fabiomatos999/ICOM-4217-Project/Final Project Report/Introduction/introduction.tex

\section{Introduction}
In 2017 hurricane Maria devastated the northeastern Caribbean, particularly Dominica, Saint Croix, and Puerto Rico. In the wake of the storm, Puerto Rico suffered the longest blackout in US history and the second longest blackout in recorded human history\cite{WorldSecondLargest}. The revised death count attributable to the hurricane was 2,975 people\cite{HurricaneMariaCaused2018}. According to an investigation by the New York Times, deaths caused by  sepsis, pneumonia, emphysema, diabetes, and Alzheimer's and Parkinson's spiked in the two months following the hurricane\cite{roblesOfficialTollPuerto2017}. The whole island of Puerto Rico was declared a disaster zone by the Federal Emergency Management Agency (FEMA) and it wasn't until four to eight months after the storm that most of the population had electricity and running water after the storm. The Puerto Rican electrical grid also collapsed in the aftermath of hurricane Fiona in September of 2022. Puerto Rico also has a sizable portion of the adult population with diabetes and a large portion of those diagnosed with diabetes require insulin to survive\cite{DiabetesPrevalencePopulation}. The rationale for this project is to provide a tool for users of insulin to be sure that their medication is safe and effective in normal and post disaster conditions. The problem is that there has not been a way to monitor the storage conditions of insulin in a consumer setting in normal/post-disaster conditions. This project's solution to this problem is to create a micro-controller based design that can:
\begin{itemize}
  \item Monitor the temperature of the insulin.
  \item Check if a power outage has occurred.
  \item Warn the main unit if the temperature has exceeded has deviated from the recommended guidelines, 2\si{\celsius} to 8\si{\celsius}, and turn on a warning light on the sub unit.
  \item Record the temperature, timestamp and power availability on a log file on the main unit.
  \item Let the main unit warn an operator if a sub-unit has exceeded temperature guidelines.
  \item The main unit send its logging information to a server.
\end{itemize}
