fabiomatos999/ICOM-4217-Project/Final Project Report/Title-Page/title-page.tex

\begin{titlepage}
  \begin{center}
    \large{University of Puerto Rico\\
    Mayagüez Campus\\
    \vspace{\baselineskip}
    Department of Electrical and Computer Engineering\\}
    \vspace{6cm}
    \Huge{\underline{Insulin Temperature Warning System}\\}
    \vspace{0.3\baselineskip}
    \large{Final Report\\}
    \vspace{0.8\baselineskip}
    \large by\\
    Fabio J. Matos Nieves\\
    Enrique Chompré González\\
    \vspace{5.5cm}
    For: Professor Manuel Jimenez\\
    Course: ICOM 4217 Seccion 096\\
    Date: May 8, 2023\\
    \normalsize

  \end{center}
\end{titlepage}
