fabiomatos999/ICOM-4217-Project/PROTOTYPE INTEGRATION and System Updates/System-Schematic-Diagrams/system-schematic-diagrams.tex

\section{System Schematic Diagrams}
\begin{landscape}
  \begin{center}
  \begin{figure}[H]
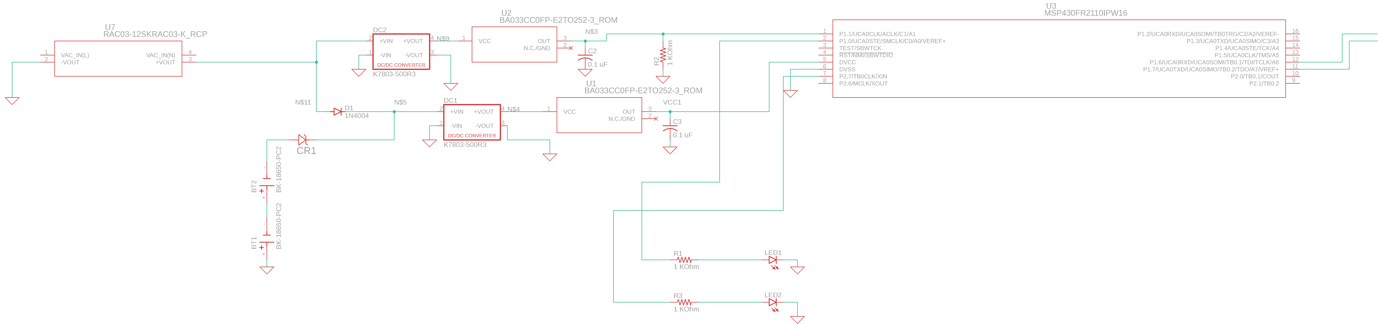
[picture p9: PROTOTYPE INTEGRATION and System Updates/System-Schematic-Diagrams/Figures/main-unit-and-psu.png]
    
    \caption{Main Unit with PSU Schematic}
    \label{fig:main-with-psu-schematic}
  \end{figure}
  \end{center}
  \begin{center}
  \begin{figure}[H]
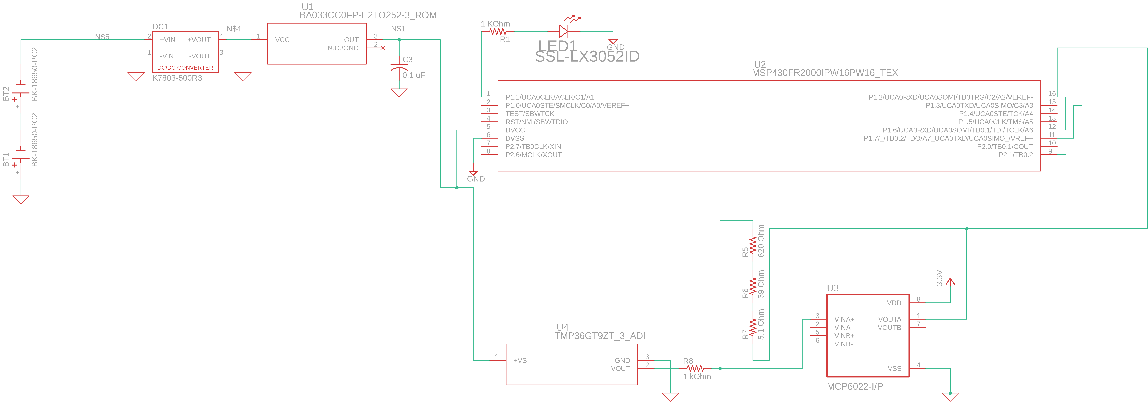
[picture p10: PROTOTYPE INTEGRATION and System Updates/System-Schematic-Diagrams/Figures/sub-unit-and-psu.png]
    
    \caption{Sub Unit with PSU Schematic}
    \label{fig:sub-with-psu-schematic}
  \end{figure}
  \end{center}
\end{landscape}
