fabiomatos999/ICOM-4217-Project/Hardware Design and System Updates/Main-Document/main-document.tex

\documentclass[12pt]{article}
\usepackage{amsmath}
\usepackage[export]{adjustbox}
\usepackage{unicode}
\usepackage[table]{xcolor}
\usepackage{longtable}
\usepackage{pdflscape}
\usepackage{siunitx}
\usepackage{svg}
\usepackage{setspace}
\usepackage[scaled]{helvet}
\renewcommand\familydefault{\sfdefault} 
\usepackage[T1]{fontenc}
\usepackage[numbers]{natbib} 
\usepackage{tabularx}
\usepackage[hidelinks]{hyperref} 
\hypersetup{ colorlinks, citecolor=black,
  filecolor=black, 
  linkcolor=black,
  urlcolor=blue,
  pdftitle={Hardware Design and System Updates},
  pdfpagemode=FullScreen,
}
\usepackage{float}
\usepackage{graphicx} 
\usepackage{pdfpages} 
\usepackage{tabularx}
\usepackage{tikz}
\newcommand\createfigurew[3]{
  \begin{center}
  \begin{figure}[H]
    \centering 
    \caption{#2}
    \label{#3}
  \end{figure}
  \end{center}
}
\newcommand\createfigurel[3]{
  \begin{center}
  \begin{figure}[H]
    \centering 
    \caption{#2}
    \label{#3}
  \end{figure}
  \end{center}
}
\newcommand\createfigurewsvg[3]{
 \begin{figure}[H]
  \begin{center}
    \centering\includesvg[width=\textwidth]{#1}
    \caption{#2}
    \label{#3}
  \end{center}
 \end{figure}
}
\usepackage{etoolbox}
\apptocmd{\thebibliography}{\raggedright}{}{}
\begin{document}
\linespread{1.0}
\input{../Title-Page/title-page.tex}
\linespread{2.0}
\tableofcontents
\listoffigures
\listoftables
\input{../Task-Delegation/task-delegation.tex}
\input{../BDv3/bdv3.tex}
\input{../System-Schematic-Diagrams/system-schematic-diagrams.tex}
\input{../BOM/bom.tex}
\input{../Power-Voltage-Compatability-and-Timing-Analyses/power-voltage-compatability-and-timing-analysis.tex}
\input{../Cost Analysis/cost-analysis.tex}
\input{../Detailed-Software-Plan/detailed-software-plan.tex}
\input{../Updated-Project-Poster/updated-project-poster.tex}
\input{../References/references.tex}
\end{document}
