fabiomatos999/ICOM-4217-Project/Hardware Design and System Updates/System-Schematic-Diagrams/system-schematic-diagrams.tex

\section{System Schematic Diagrams}
\begin{landscape}
  \begin{center}
  \begin{figure}[H]
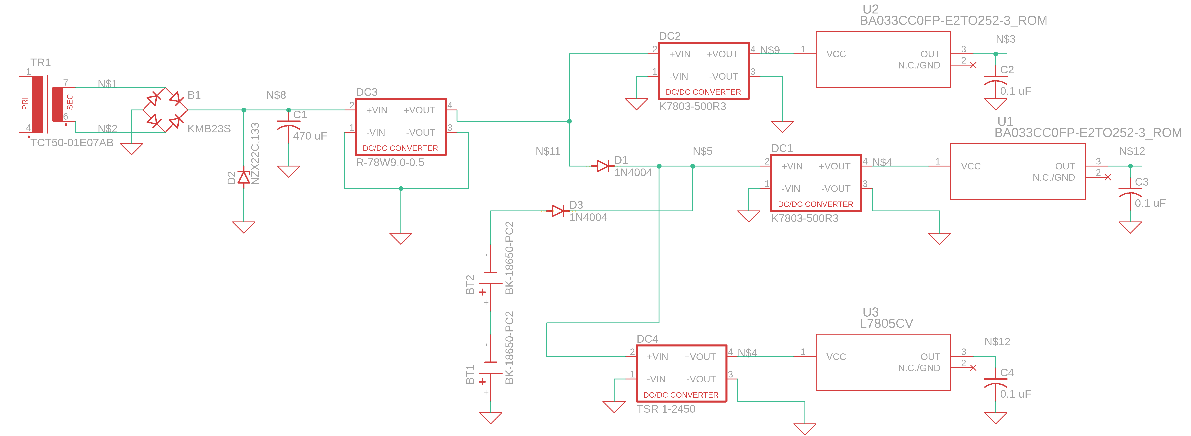
[picture p11: Hardware Design and System Updates/Power-Supply/Main Unit PSU/main-unit-psu.png]
    
    \caption{Main Unit PSU Schematic}
    \label{fig:main-psu-schematic}
  \end{figure}
  \end{center}
\createfigurew{../Power-Supply/Sub Unit PSU/sub-unit-psu.png}{Sub Unit PSU Schematic}{fig:sub-psu-schematic}
  \begin{center}
  \begin{figure}[H]
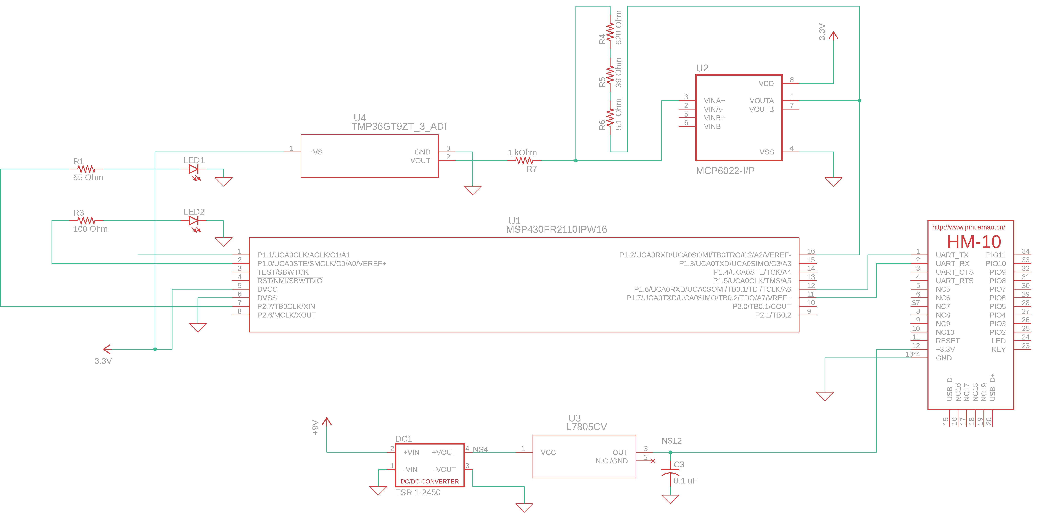
[picture p12: Hardware Design and System Updates/Main-Unit/Figures/Main-Unit.png]
    
    \caption{Main Unit Schematic}
    \label{fig:main-unit-schematic}
  \end{figure}
  \end{center}
  \begin{center}
  \begin{figure}[H]
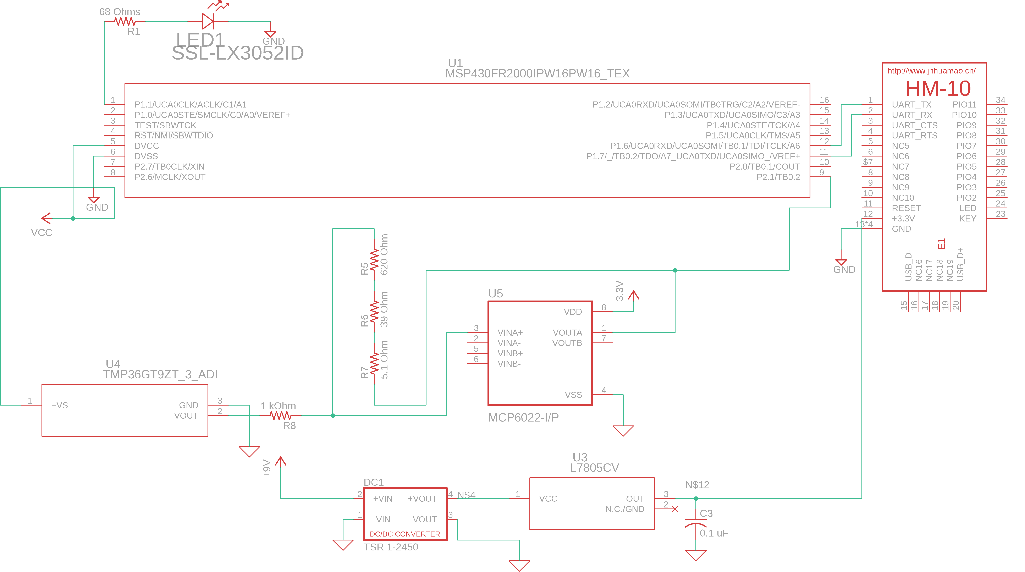
[picture p13: Hardware Design and System Updates/Sub-Unit/Figures/sub-unit.png]
    
    \caption{Sub Unit Schematic}
    \label{fig:sub-unit-schematic}
  \end{figure}
  \end{center}
  \begin{center}
  \begin{figure}[H]
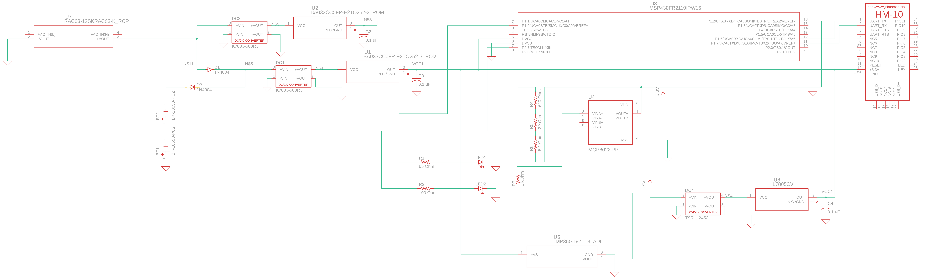
[picture p14: Hardware Design and System Updates/Main-Unit-and-PSU/Figures/main-unit-and-psu.png]
    
    \caption{Main Unit with PSU Schematic}
    \label{fig:main-with-psu-schematic}
  \end{figure}
  \end{center}
  \begin{center}
  \begin{figure}[H]
    
    \caption{Sub Unit with PSU Schematic}
    \label{fig:sub-with-psu-schematic}
  \end{figure}
  \end{center}
\end{landscape}
