fabiomatos999/ICOM-4217-Project/Hardware Design and System Updates/Task-Delegation/task-delegation.tex

\section{Delegation of Tasks}
For this proposal, the Insulin Temperature Warning System was modulerized into 3 separate parts, those being:
\begin{itemize}
  \item Main Unit
  \item Sub Unit
  \item PSU
\end{itemize}
The main unit consists of the MSP430FR2110 and the HM-10 BLE Bluetooth module. The sub unit consists of MSP430FR2000, a HM-10 BLE Bluetooth module and a red LED. The PSU consists of 2 individual parts:
\begin{itemize}
  \item Main Unit PSU
  \item Sub unit PSU
\end{itemize}
The main unit consists of a 3.3\si{\V} power supply along with a 3.3\si{\V} voltage sense for a GPIO pin with a battery backup circuit.  The sub unit PSU consists of a 3.3\si{\V} regulated battery supply.\\
The following table demonstrates how the modules were distributed within the team:
\begin{table}[h]
\begin{center}
\begin{tabularx}{\textwidth}{|X|X|}
 \hline
 Team Member & Assigned Module\\
 \hline
 Fabio J. Matos Nieves & PSU\\
 \hline
 Enrique Chompré González& Main Unit\\
 \hline
 Guillermo Colón Bernardi& Sub Unit\\
 \hline
\end{tabularx}
\end{center}
\caption{Team Member Roles}
\label{Task-Delegation}
\end{table}
