fabiomatos999/ICOM-4217-Project/Hardware Design and System Updates/Title-Page/title-page.tex

\begin{titlepage}
  \begin{center}
    \large{University of Puerto Rico\\
    Mayagüez Campus\\
    \vspace{\baselineskip}
    Department of Electrical and Computer Engineering\\}
    \vspace{6cm}
    \Huge{\underline{Insulin Temperature Warning System}\\}
    \vspace{0.5\baselineskip}
    \large by\\
    Fabio J. Matos Nieves\\
    Enrique Chompré González\\
    Guillermo Colón Bernardi\\
    \vspace{4.5cm}
    For: Professor Manuel Jimenez\\
    Course: ICOM 4217 Seccion 096\\
    Date: March 13, 2023\\
    \normalsize

  \end{center}
\end{titlepage}
