fabiomatos999/ICOM-4217-Project/Proposal/Design-Criteria/design-criteria.tex

\section{Design Criteria}
\begin{enumerate}
  \item Power/Energy: The sub-units are supposed to last at least 2 years only using a battery and the main unit is supposed to operate on a UPS for an extended period of time in case of a blackout, thus being cognizant of a power budget is critical for this design.
  \item Economic: This design is supposed to be inexpensive enough so that the sub-units can be embedded in a box of insulin at a factory or pharmacy.
  \item Manufacturability: This design used off the shelf parts that are being actively manufactured and are easy to assemble and can easily fit in a box of insulin.
\end{enumerate}
