fabiomatos999/ICOM-4217-Project/Proposal/Abstract/abstract.tex

\section*{Abstract}
The purpose of this document is outlining a design for a pair of devices that monitor the temperature of insulin, making sure that it meets the safe storage guidelines in a mass storage context. This document contains the system conception, system architecture \& functionality, specifications and market description as well as the project time table, design criteria and the opinion of the client of this design.
