fabiomatos999/ICOM-4217-Project/PROTOTYPE INTEGRATION and System Updates/System-Schematic-Diagrams/Main-Unit/Main-Unit-Schematic.txt

Partlist exported from C:/Users/enriq/Documents/EAGLE/projects/ICOM4217/Main-Unit-Schematic.sch at 3/12/2023 8:02 PM

Qty Value             Device            Package           Parts Description                                                                                                                                                                                                                                                          AVAILABILITY COPYRIGHT                                                DESCRIPTION                                                                     MANUFACTURER_PART_NUMBER MF                      MFR_NAME          MP    PACKAGE  PRICE
1   HM-10-BOARD       HM-10-BOARD       26.9X13X2.2_BOARD E1    HM Bluetooth module use TI CC2540 or CC2541, Master and slave roles in one, transmission version and remote control version and PIO state acquisition functions in one, Support the AT command modify module parameters, Convenient and flexible. Check availability Not in stock                                                           Bluetooth 4.0 module with 4pin base board that can support iphone4s or later.                           Jinan Huamao Technology                   HM-10 Package  None 
1   MSP430FR2110IPW16 MSP430FR2110IPW16 PW16_TEX          U1                                                                                                                                                                                                                                                                                      Copyright (C) 2023 Ultra Librarian. All rights reserved.                                                                                 MSP430FR2110IPW16                                Texas Instruments
