fabiomatos999/ICOM-4217-Project/PROTOTYPE INTEGRATION and System Updates/Main-Document/main-document.tex

\documentclass[12pt]{article}
\usepackage{setspace}
\usepackage{float}
\usepackage{svg}
\usepackage{pdflscape}
\usepackage{longtable}
\usepackage{tikz}
\usepackage{amsmath}
\usepackage[scaled]{helvet}
\renewcommand\familydefault{\sfdefault}
\usepackage{caption}
\usepackage{subcaption}
\usepackage[hidelinks]{hyperref}
\usepackage[numbers]{natbib}
\usepackage{tabularx}
\usepackage[export]{adjustbox}
\hypersetup{ colorlinks, citecolor=black,
  filecolor=black,
  linkcolor=black,
  urlcolor=blue,
  pdftitle={Hardware Design and System Updates},
  pdfpagemode=FullScreen,
}
\usepackage{siunitx}
\usepackage{tabularx}
\usepackage{bookmark}
\bookmarksetup{
  numbered,
  open,
}
\usepackage{caption}
\usepackage[newfloat]{minted}
\newcommand\createfigurew[3]{
  \begin{center}
  \begin{figure}[H]
    \centering 
    \caption{#2}
    \label{#3}
  \end{figure}
  \end{center}
}
\newcommand\createfiguresw[4]{
  \begin{center}
  \begin{figure}[H]
    \centering 
    \caption{#3}
    \label{#4}
  \end{figure}
  \end{center}
}
\newcommand\createfigurel[3]{
  \begin{center}
  \begin{figure}[H]
    \centering 
    \caption{#2}
    \label{#3}
  \end{figure}
  \end{center}
}
\newcommand\createfigurewsvg[3]{
 \begin{figure}[H]
  \begin{center}
    \centering\includesvg[width=\textwidth]{#1}
    \caption{#2}
    \label{#3}
  \end{center}
 \end{figure}
}
\usepackage{etoolbox}
\apptocmd{\thebibliography}{\raggedright}{}{}
\newenvironment{code}{\captionsetup{type=listing}}{}
\SetupFloatingEnvironment{listing}{name=Source Code}
\begin{document}
\linespread{1.0}
 \input{../Title-Page/title-page.tex}
\linespread{2.0}
 \tableofcontents
 \listoffigures
 \listoftables
 \input{../Completion-Table/completion-table.tex}
 \input{../BDv5/BDv5.tex}
 \input{../System-Schematic-Diagrams/system-schematic-diagrams.tex}
 \input{../Bill-Of-Materials/bill-of-materials.tex}
 \input{../Power-Voltage-Compatability-Timing-Analysis/power-voltage-compatability-timing-analysis.tex}
 \input{../System-Integration-Table/system-integration-table.tex}
 \input{../System-Core-Design/system-core-design.tex}
 \input{../Individual-BD-SCH-Pictures/individual-bd-sch-pictures.tex}
 \input{../References/references.tex}
 \input{../Detailed-Software-Plan-Per-Module/detailed-software-plan-per-module.tex}
\end{document}
