fabiomatos999/ICOM-4217-Project/PROTOTYPE INTEGRATION and System Updates/Detailed-Software-Plan-Per-Module/detailed-software-plan-per-module.tex

\appendix
\section{Detailed Software Plan Per Module}
\subsection{Main Unit}
\createfiguresw{0.50\textwidth}{../Detailed-Software-Plan-Per-Module/Figures/main-unit-main-function.png}{Main Unit Main Function Flowchart}{fig:main-unit-main-function-flowchart}
\createfiguresw{0.54\textwidth}{../Detailed-Software-Plan-Per-Module/Figures/main-unit-rtc-isr.png}{Main Unit RTC ISR Flowchart}{fig:main-unit-rtc-isr-flowchart}
\createfigurew{../Detailed-Software-Plan-Per-Module/Figures/main-unit-bluetooth-isr.png}{Main Unit Bluetooth ISR Flowchart}{fig:main-unit-bluetooth-isr-flowchart}
\input{../Detailed-Software-Plan-Per-Module/Figures/main-unit-fsd.tex}
\newpage
\createfigurew{../Detailed-Software-Plan-Per-Module/Figures/main-unit-main-function-pseudo-code.png}{Main Unit Main Function Pseudo Code}{fig:main-unit-main-function-pseudo-code}
\createfigurew{../Detailed-Software-Plan-Per-Module/Figures/main-unit-rtc-isr-pseudo-code.png}{Main Unit RTC ISR Pseudo Code}{fig:main-unit-rtc-isr-pseudo-code}
\createfigurew{../Detailed-Software-Plan-Per-Module/Figures/main-unit-bluetooth-isr-pseudo-code.png}{Main Unit Bluetooth ISR Pseudo Code}{fig:main-unit-bluetooth-isr-pseudo-code}
\begin{code}
\captionof{listing}{Main Unit main.c}
\label{code:main-unit-main.h}
 \begin{minted}[breaklines,breakanywhere]{C}
#include <msp430.h> 
#include <temperatureSensor.h>
#include <bluetooth.h>

typedef enum
{
    OLD, FROZEN, COLD, WARM, HOT, TRASH, NONE
} ERROR;

char*ERROR_STRING[7] = {
    "OLD",
    "FROZEN",
    "COLD",
    "WARM",
    "HOT",
    "TRASH",
    "NONE"
};

char LOT[30] = "ABCDEFGHIJKLMNOPQRSTUVWXYZ1234";

void raiseError(ERROR err);

unsigned char ownerAddr[12];
unsigned char subAddr[12];
const unsigned int expDateHours = 17520;
ERROR error = NONE;

int main(void)
{
    WDTCTL = WDTPW | WDTHOLD;   // stop watchdog timer

//    PM5CTL0 &= ~LOCKLPM5;//sends GPIO pins to low impedance mode
    P4OUT &= ~(BIT1 + BIT0);
    P4DIR |= BIT1+BIT0;//P2.1 = GREEN LED, P2.0= RED LED, P2.2= Voltage sensing pin
    P1REN |= BIT3;
    P1IE |= BIT3;
    if (((P1IN>>3)& 1)==1){//verifies that power is present
                P4OUT &= ~BIT0;
                P4OUT |= BIT1;
                P1IES |= BIT3;
                //toggles LEDs
            }
            else {
                P4OUT &= ~BIT1;
                P4OUT |= BIT0;
                P1IES &= ~BIT3;

                //toggles LEDs
            }
    P1IFG &= ~BIT3;
    P1SEL0 |= BIT6 + BIT7;//UART Pins P1.6=RX, P1.7=TX
    UCA0CTLW0 |= UCSWRST;
    UCA0CTLW0 |= UCSSEL_2;
    UCA0BR0 = 6; //baud rate
    UCA0BR1 = 0x00;
    UCA0MCTLW = UCOS16 + (13<<4) + (0x22<<8);
    UCA0CTLW0 &= ~UCSWRST;
    UCA0IE |= UCRXIE;//enable interrupts for the receiver
    P3SEL = BIT4 + BIT5;
    UCA0CTL1 |= UCSWRST;
    UCA0CTL1 |= UCSSEL_2;
    UCA0BR0 = 109;
    UCA0BR1 = 0x00;
    UCA0MCTL = UCBRS_2+UCBRF_0;
    UCA0CTL1 &= ~UCSWRST;
    UCA0IE |= UCTXIE + UCRXIE;
    UCA0TXBUF = 'A';
    __enable_interrupt();
    __bis_SR_register(LPM3_bits | GIE);
    __no_operation();
}

#pragma vector=PORT1_VECTOR
__interrupt void PORT1_ISR(void)
{
    switch(__even_in_range(P1IV,16)){
    case 8:
        if (((P1IN>>3)& 1)==1){//verifies that power is present
            P4OUT &= ~BIT0;
            P4OUT |= BIT1;
            P1IES |= BIT3;

            //toggles LEDs
        }
        else {
            P4OUT &= ~BIT1;
            P4OUT |= BIT0;
            P1IES &= ~BIT3;
            //toggles LEDs
        }
    break;
    default:
    break;
    }
    __bis_SR_register_on_exit(LPM3_bits);

}

#pragma vector=USCI_A0_VECTOR
__interrupt void USCI_A0_ISR(){
    switch(__even_in_range(UCA0IV,4)){//takes first 3 bits
    case 0: break; //Irrelevant
    case 2:
        if (rxcharindex < BTBUFSIZE && rxcharindex < strlen(BTRXBUF)){
            UCA0RXBUF = BTRXBUF[rxcharindex];//receiver buffer
            rxcharindex += 1;
        }
        break;
    case 4:
        if (txcharindex < BTBUFSIZE && txcharindex < strlen(BTTXBUF)){
            UCA0TXBUF = BTTXBUF[txcharindex];//transmitter buffer
            txcharindex += 1;
        }
        break;
    default: break;
    }
}
 \end{minted}
\end{code}
\begin{code}
\captionof{listing}{Main Unit Bluetooth.h}
\label{code:main-unit-bluetooth.h}
 \begin{minted}[breaklines,breakanywhere]{C}
#include <stdio.h>
#include <string.h>

#define BTBUFSIZE 81
char BTTXBUF[BTBUFSIZE];
char BTRXBUF[BTBUFSIZE];

unsigned int txcharindex = 0;
unsigned int rxcharindex = 0;

char *AT_COMMANDS[] = {
        "AT\0",           // 0 Test Command
        "AT+ADDR?\0",     // 1 Query module address
        "AT+BAUD?\0",     // 2 Query baud rate
        "AT+BAUD[]\0",    // 3 Set baud rate
        "AT+CLEAR\0",     // 4 Clear Last Connected device address
        "AT+CONNL\0",     // 5 Try connect to last succeeded device
        "AT+CON[]\0",     // 6 Try connect an address
        "AT+FILT?\0",     // 7 Query filter AT command parameter in AT+MODE value is 2
        "AT+FILT[]\0",    // 8 Set filter AT command parameter in AT+MODE value is 2
        "AT+HELP?\0",     // 9 System Help Information
        "AT+IMME?\0",     // 10 Query Module work type
        "AT+IMME[]\0",    // 11 Set Module work type
        "AT+MODE?\0",     // 12 Query Module Work Mode
        "AT+MODE[]\0",    // 13 Set Module Work Mode
        "AT+NOTI\0",      // 14 Query Notify information
        "AT+NOTI[]\0",    // 15 Set Notify information
        "AT+NAME?\0",     // 16 Query Module name
        "AT+NAME[]\0",    // 17 Set Module name
        "AT+PARI?\0",     // 18 Query Parity bit
        "AT+PARI[]\0",    // 19 Set Parity bit
        "AT+PIO1?\0",     // 20 Query PIO1 output status (System LED)
        "AT+PIO1[]\0",    // 21 Set PIO1 output status (System LED)
        "AT+PIO[]?\0"     // 22 Query/Set PIO pins output high or low (Only this time, when module next power on, this value is not be used)
        "AT+PIO[][]\0",   // 23 Query/Set PIO pins output high or low (Only this time, when module next power on, this value is not be used)
        "AT+PASS?\0",     // 24 Query Pin Code
        "AT+PIN[]\0",     // 25 Set Pin Code
        "AT+POWE?\0",     // 26 Query Module Power
        "AT+POWE[]\0",    // 27 Set Module Power
        "AT+PWRM?\0",     // 28 Query Module sleep type
        "AT+PWRM[]\0",    // 29 Set Module sleep type
        "AT+RENEW\0",     // 30 Restore all setup value to factory setup
        "AT+RESET\0",     // 31 Restart module
        "AT+ROLE?\0",     // 32 Query Master and Slaver Role
        "AT+ROLE[]\0",    // 33 Set Master and Slaver Role
        "AT+RSSI?\0",     // 34 Query RSSI Value
        "AT+RADD\0",      // 35 Query Last Connected Device Address
        "AT+STOP?\0"      // 36 Query Stop bit
        "AT+STOP[]\0",    // 37 Set Stop bit
        "AT+START\0",     // 38 Work immediately
        "AT+SLEEP\0",     // 39 Query Module into sleep mode
        "AT+SAVE?\0",     // 40 Query Module save connected address parameter
        "AT+SAVE[]\0",    // 41 Set Module save connected address parameter
        "AT+TCON?\0",     // 42 Query module connect remote device timeout value
        "AT+TCON[]\0",    // 43 Set module connect remote device timeout value
        "AT+TYPE?\0",     // 44 Query Module Bond Mode
        "AT+TYPE[]\0",    // 45 Set Module Bond Mode
        "AT+VERR?\0",     // 46 Query Software Version
        "AT+VERS?\0"      // 47 Query Software Version
        };

void resetBuffer(char *buf)
{
    unsigned int i = 0;
    for (; i < BTBUFSIZE; i++)
    {
        buf[i] = '\0';
    }
}

int commandPosition(char *command)
{
    unsigned int i = 0;
    for (; i < 47; i++)
    {
        if (strcmp(AT_COMMANDS[i], command) == 0)
        {
            return i;
        }
    }
    return -1;
}

void printBufferNoArgs(char *buff, char *command)
{
    resetBuffer(buff);
    sprintf(buff, "%s", command);
}

void printBufferOneArg(char *buff, char *command, char *parm1)
{
    resetBuffer(buff);
    char commandCopy[BTBUFSIZE];
    strcpy(commandCopy, buff);
    unsigned int i = 0;
    for (; i < BTBUFSIZE; i++)
    {
        if (commandCopy[i] == '[' || commandCopy[i] == ']')
            commandCopy[i] = '\0';
    }
    sprintf(buff, "%s[%s]", command, parm1);
}

void printBufferTwoArg(char *buff, char *command, char *parm1, char *parm2)
{
    resetBuffer(buff);
    char commandCopy[BTBUFSIZE];
    strcpy(commandCopy, buff);
    unsigned int i = 0;
    for (; i < BTBUFSIZE; i++)
    {
        if (commandCopy[i] == '[' || commandCopy[i] == ']')
            commandCopy[i] = '\0';
    }
    sprintf(buff, "%s[%s][%s]", command, parm1, parm2);
}

void executeAT_Command(char *command, char *parm1, char *parm2)
{
    switch (commandPosition(command))
    {
    case 0:
        printBufferNoArgs(BTTXBUF, command);
        UCA0IE |= UCRXIE;
        break;
    case 1:
        printBufferNoArgs(BTTXBUF, command);
        UCA0IE |= UCRXIE;
        break;
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
        UCA0IE |= UCRXIE;
        break;
    case 44:
        printBufferNoArgs(BTTXBUF, command);
        UCA0IE |= UCRXIE;
        break;
    case 45:
        printBufferOneArg(BTTXBUF, command, parm1);
        UCA0IE |= UCRXIE;
        break;
    case 46:
        printBufferNoArgs(BTTXBUF, command);
        UCA0IE |= UCRXIE;
        break;
    case 47:
        printBufferNoArgs(BTTXBUF, command);
        UCA0IE |= UCRXIE;
        break;
    default:
        break;
    }
}
  \end{minted}
\end{code}
\subsection{Sub Unit}
\createfiguresw{0.50\textwidth}{../Detailed-Software-Plan-Per-Module/Figures/sub-unit-main-function.png}{Sub Unit Main Function Flowchart}{fig:sub-unit-main-function-flowchart}
\createfiguresw{0.75\textwidth}{../Detailed-Software-Plan-Per-Module/Figures/sub-unit-rtc-isr.png}{Sub Unit RTC ISR Flowchart}{fig:sub-unit-rtc-isr-flowchart}
\createfiguresw{0.75\textwidth}{../Detailed-Software-Plan-Per-Module/Figures/sub-unit-bluetooth-isr.png}{Sub Unit Bluetooth ISR Flowchart}{fig:sub-unit-bluetooth-isr-flowchart}
\input{../Detailed-Software-Plan-Per-Module/Figures/sub-unit-fsd.tex}
\createfigurew{../Detailed-Software-Plan-Per-Module/Figures/sub-unit-main-function-pseudo-code.png}{Sub Unit Main Function Pseudo Code}{fig:sub-unit-main-function-pseudo-code}
\createfigurew{../Detailed-Software-Plan-Per-Module/Figures/sub-unit-rtc-isr-pseudo-code.png}{Sub Unit RTC ISR Pseudo Code}{fig:sub-unit-rtc-isr-pseudo-code}
\createfigurew{../Detailed-Software-Plan-Per-Module/Figures/sub-unit-bluetooth-isr-pseudo-code.png}{Sub Unit Bluetooth ISR Pseudo Code}{fig:sub-unit-bluetooth-isr-pseudo-code}
\linespread{1.0}
\begin{code}
\captionof{listing}{Sub Unit Main.c}
\label{code:sub-unit-main-func}
\begin{minted}[breaklines,breakanywhere]{C}
#include <msp430.h>
#include <temperatureSensor.h>

char at[] = "AT+ADDR?\n\r\0";

char BUFF[10];

unsigned int i = 0;

typedef enum
{
    OLD, FROZEN, COLD, WARM, HOT, TRASH, NONE
} ERROR;

char*ERROR_STRING[7] = {
    "OLD",
    "FROZEN",
    "COLD",
    "WARM",
    "HOT",
    "TRASH",
    "NONE"
};

char LOT[30] = "ABCDEFGHIJKLMNOPQRSTUVWXYZ1234";

void checkExpDate();
void raiseError(ERROR err);

unsigned int currHour = 0;
const unsigned int expDateHours = 17520;
ERROR error = NONE;

int main(void)
{
    WDTCTL = WDTPW | WDTHOLD;	// stop watchdog timer

    P6SEL |= BIT7;
    ADC12CTL0 |= ADC12SHT0_15 + ADC12ON;
    ADC12CTL1 = ADC12SHP;
    ADC12MCTL0 |= ADC12INCH_7 + ADC12SREF_7;
    ADC12IE |= BIT0;
    ADC12CTL0 |= ADC12ENC;

    RTCCTL01 = RTCTEVIE + RTCSSEL_2 + RTCTEV_0; // Counter Mode, RTC1PS, 8-bit ovf
                                              // overflow interrupt enable
    RTCPS0CTL = RT0PSDIV_3;                   // ACLK, /8, start timer
    RTCPS1CTL = RT1SSEL_2 + RT1PSDIV_3;       // out from RT0PS, /16, start timer

    P1DIR |= BIT4;
    P1OUT &= ~BIT4;

    P3SEL = BIT4 + BIT5;
    UCA0CTL1 |= UCSWRST;
    UCA0CTL1 |= UCSSEL_2;
    UCA0BR0 = 109;
    UCA0BR1 = 0x00;
    UCA0MCTL = UCBRS_2+UCBRF_0;
    UCA0CTL1 &= ~UCSWRST;
    UCA0IE |= UCTXIE + UCRXIE;
    __enable_interrupt();

    __delay_cycles(10000);
    __bis_SR_register(LPM3_bits);
}

#if defined(_TI_COMPILER_VERSION) || defined(IAR_SYSTEMS_ICC_)
#pragma vector=RTC_VECTOR
__interrupt void RTC_ISR(void)
#elif defined(_GNUC_)
void _attribute_ ((interrupt(RTC_VECTOR))) RTC_ISR (void)
#else
#error Compiler not supported!
#endif
{
  switch(__even_in_range(RTCIV,16))
  {
    case 0: break;                          // No interrupts
    case 2: break;                          // RTCRDYIFG
    case 4:                                 // RTCEVIFG
        currHour += 1;
        unsigned int i = 0;
        for (; i < TEMPBUFSIZE; i++)
        {
            ADC12CTL0 |= ADC12SC;
            while (ADC12CTL1 & ADC12BUSY);
            voltage = ADC12MEM0;
            tempts[tempindex] = (voltage-500) / 10.0;
            tempindex = (++tempindex) % TEMPBUFSIZE;
        }
        float average = average_celsius();
        if (average < 2 || average > 8)
        {
            if (average <= 0)
            {
                raiseError(FROZEN);
            }
            else if (average > 0 && average < 2)
            {
                raiseError(COLD);
            }
            else if (average > 8 && average < 15)
            {
                raiseError(WARM);
            }
            else if (average >= 15 && average < 30)
            {
                raiseError(WARM);
            }
            else
            {
                raiseError(TRASH);
            }
        }
        checkExpDate();
        if (error == NONE)
        {
            P1OUT &= ~BIT4;
        }

        __bic_SR_register_on_exit(LPM3_bits);   // Exit active CPU
      break;
    case 6: break;                          // RTCAIFG
    case 8: break;                          // RT0PSIFG
    case 10: break;                         // RT1PSIFG
    case 12: break;                         // Reserved
    case 14: break;                         // Reserved
    case 16: break;                         // Reserved
    default: break;
  }
}

void checkExpDate()
{
    if (currHour > expDateHours)
    {
        error = OLD;
    }
}

void raiseError(ERROR err)
{
    error = err;
    P1OUT |= BIT4;
    sprintf(BTTXBUF,"%s %s",LOT,ERROR_STRING[err]);
    UCA0IE |= UCTXIE;

}

#pragma vector=USCI_A0_VECTOR
__interrupt void USCI_A0_ISR(){

    switch(__even_in_range(UCA0IV,4)){
    case 0: break;
    case 2:
        BUFF[i] = UCA0RXBUF;
        i = (++i)%10;
        volatile char buffcpy[10] = BUFF;
        break;
    case 4:
        UCA0TXBUF = 'A';
        break;
    default: break;
    }
}
\end{minted}
\end{code}
\begin{code}
\captionof{listing}{Sub Unit Temperature Sensor Library}
\label{code:sub-unit-temp-func}
\begin{minted}[breaklines,breakanywhere]{C}
#define TEMPBUFSIZE 10

float tempts[TEMPBUFSIZE];
unsigned int tempindex = 0;
unsigned int voltage = 0;

float average_celsius(){
    float total= 0;
    unsigned int i = 0;
    for(;i<TEMPBUFSIZE;i++){
        total +=tempts[i];
    }
    return total/((float)TEMPBUFSIZE);
}
\end{minted}
\end{code}
\begin{code}
\captionof{listing}{Sub Unit Bluetooth.h}
\label{code:sub-unit-bluetooth.h}
 \begin{minted}[breaklines,breakanywhere]{C}
#include <stdio.h>
#include <string.h>

#define BTBUFSIZE 81
char BTTXBUF[BTBUFSIZE];
char BTRXBUF[BTBUFSIZE];

unsigned int txcharindex = 0;
unsigned int rxcharindex = 0;

char *AT_COMMANDS[] = {
        "AT\0",           // 0 Test Command
        "AT+ADDR?\0",     // 1 Query module address
        "AT+BAUD?\0",     // 2 Query baud rate
        "AT+BAUD[]\0",    // 3 Set baud rate
        "AT+CLEAR\0",     // 4 Clear Last Connected device address
        "AT+CONNL\0",     // 5 Try connect to last succeeded device
        "AT+CON[]\0",     // 6 Try connect an address
        "AT+FILT?\0",     // 7 Query filter AT command parameter in AT+MODE value is 2
        "AT+FILT[]\0",    // 8 Set filter AT command parameter in AT+MODE value is 2
        "AT+HELP?\0",     // 9 System Help Information
        "AT+IMME?\0",     // 10 Query Module work type
        "AT+IMME[]\0",    // 11 Set Module work type
        "AT+MODE?\0",     // 12 Query Module Work Mode
        "AT+MODE[]\0",    // 13 Set Module Work Mode
        "AT+NOTI\0",      // 14 Query Notify information
        "AT+NOTI[]\0",    // 15 Set Notify information
        "AT+NAME?\0",     // 16 Query Module name
        "AT+NAME[]\0",    // 17 Set Module name
        "AT+PARI?\0",     // 18 Query Parity bit
        "AT+PARI[]\0",    // 19 Set Parity bit
        "AT+PIO1?\0",     // 20 Query PIO1 output status (System LED)
        "AT+PIO1[]\0",    // 21 Set PIO1 output status (System LED)
        "AT+PIO[]?\0"     // 22 Query/Set PIO pins output high or low (Only this time, when module next power on, this value is not be used)
        "AT+PIO[][]\0",   // 23 Query/Set PIO pins output high or low (Only this time, when module next power on, this value is not be used)
        "AT+PASS?\0",     // 24 Query Pin Code
        "AT+PIN[]\0",     // 25 Set Pin Code
        "AT+POWE?\0",     // 26 Query Module Power
        "AT+POWE[]\0",    // 27 Set Module Power
        "AT+PWRM?\0",     // 28 Query Module sleep type
        "AT+PWRM[]\0",    // 29 Set Module sleep type
        "AT+RENEW\0",     // 30 Restore all setup value to factory setup
        "AT+RESET\0",     // 31 Restart module
        "AT+ROLE?\0",     // 32 Query Master and Slaver Role
        "AT+ROLE[]\0",    // 33 Set Master and Slaver Role
        "AT+RSSI?\0",     // 34 Query RSSI Value
        "AT+RADD\0",      // 35 Query Last Connected Device Address
        "AT+STOP?\0"      // 36 Query Stop bit
        "AT+STOP[]\0",    // 37 Set Stop bit
        "AT+START\0",     // 38 Work immediately
        "AT+SLEEP\0",     // 39 Query Module into sleep mode
        "AT+SAVE?\0",     // 40 Query Module save connected address parameter
        "AT+SAVE[]\0",    // 41 Set Module save connected address parameter
        "AT+TCON?\0",     // 42 Query module connect remote device timeout value
        "AT+TCON[]\0",    // 43 Set module connect remote device timeout value
        "AT+TYPE?\0",     // 44 Query Module Bond Mode
        "AT+TYPE[]\0",    // 45 Set Module Bond Mode
        "AT+VERR?\0",     // 46 Query Software Version
        "AT+VERS?\0"      // 47 Query Software Version
        };

void resetBuffer(char *buf)
{
    unsigned int i = 0;
    for (; i < BTBUFSIZE; i++)
    {
        buf[i] = '\0';
    }
}

int commandPosition(char *command)
{
    unsigned int i = 0;
    for (; i < 47; i++)
    {
        if (strcmp(AT_COMMANDS[i], command) == 0)
        {
            return i;
        }
    }
    return -1;
}

void printBufferNoArgs(char *buff, char *command)
{
    resetBuffer(buff);
    sprintf(buff, "%s", command);
}

void printBufferOneArg(char *buff, char *command, char *parm1)
{
    resetBuffer(buff);
    char commandCopy[BTBUFSIZE];
    strcpy(commandCopy, buff);
    unsigned int i = 0;
    for (; i < BTBUFSIZE; i++)
    {
        if (commandCopy[i] == '[' || commandCopy[i] == ']')
            commandCopy[i] = '\0';
    }
    sprintf(buff, "%s[%s]", command, parm1);
}

void printBufferTwoArg(char *buff, char *command, char *parm1, char *parm2)
{
    resetBuffer(buff);
    char commandCopy[BTBUFSIZE];
    strcpy(commandCopy, buff);
    unsigned int i = 0;
    for (; i < BTBUFSIZE; i++)
    {
        if (commandCopy[i] == '[' || commandCopy[i] == ']')
            commandCopy[i] = '\0';
    }
    sprintf(buff, "%s[%s][%s]", command, parm1, parm2);
}

void executeAT_Command(char *command, char *parm1, char *parm2)
{
    switch (commandPosition(command))
    {
    case 0:
        printBufferNoArgs(BTTXBUF, command);
        UCA0IE |= UCRXIE;
        break;
    case 1:
        printBufferNoArgs(BTTXBUF, command);
        UCA0IE |= UCRXIE;
        break;
    case 2:
        printBufferNoArgs(BTTXBUF, command);
        UCA0IE |= UCRXIE;
        break;
    case 3:
        printBufferOneArg(BTTXBUF, command, parm1);
        UCA0IE |= UCRXIE;
        break;
    case 4:
        printBufferNoArgs(BTTXBUF, command);
        UCA0IE |= UCRXIE;
        break;
    case 5:
        printBufferNoArgs(BTTXBUF, command);
        UCA0IE |= UCRXIE;
        break;
    case 6:
        printBufferNoArgs(BTTXBUF, command);
        UCA0IE |= UCRXIE;
        break;
    case 7:
        printBufferNoArgs(BTTXBUF, command);
        UCA0IE |= UCRXIE;
        break;
    case 8:
        printBufferOneArg(BTTXBUF, command, parm1);
        UCA0IE |= UCRXIE;
        break;
    case 9:
        printBufferNoArgs(BTTXBUF, command);
        UCA0IE |= UCRXIE;
        break;
    case 10:
        printBufferNoArgs(BTTXBUF, command);
        UCA0IE |= UCRXIE;
        break;
    case 11:
        printBufferOneArg(BTTXBUF, command, parm1);
        UCA0IE |= UCRXIE;
        break;
    case 12:
        printBufferNoArgs(BTTXBUF, command);
        UCA0IE |= UCRXIE;
        break;
    case 13:
        printBufferOneArg(BTTXBUF, command, parm1);
        UCA0IE |= UCRXIE;
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
        break;
    case 46:
        printBufferNoArgs(BTTXBUF, command);
        UCA0IE |= UCRXIE;
        break;
    case 47:
        printBufferNoArgs(BTTXBUF, command);
        UCA0IE |= UCRXIE;
        break;
    default:
        break;
    }
}
  \end{minted}
\end{code}
\linespread{2.0}
