fabiomatos999/ICOM-4217-Project/PROTOTYPE INTEGRATION and System Updates/Individual-BD-SCH-Pictures/individual-bd-sch-pictures.tex

\section{Individual Block Diagrams, Schematics and Pictures}
\subsection{Main Unit}
\subsubsection{Block Diagrams}
\createfigurewsvg{../BDv5/Figures/bdv5-main.svg}{Main Unit Architectural Block Diagram}{fig:main-bd-indv}
\subsubsection{Schematics}
\begin{landscape}
  \begin{center}
  \begin{figure}[H]
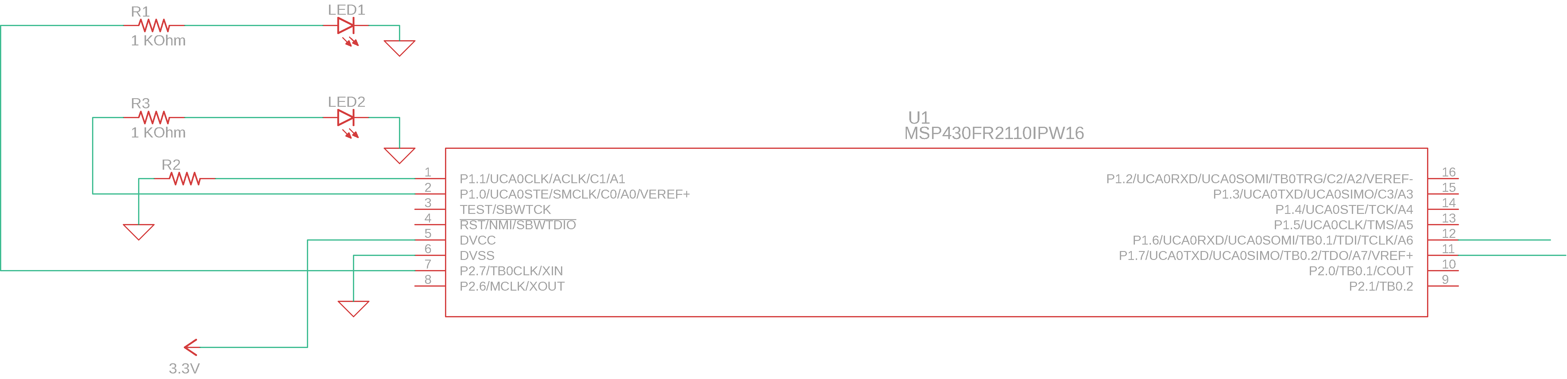
[picture p15: PROTOTYPE INTEGRATION and System Updates/System-Schematic-Diagrams/Figures/Main-Unit.png]
    
    \caption{Main Unit Schematic}
    \label{fig:main-unit-schematic}
  \end{figure}
  \end{center}
\end{landscape}
\subsubsection{Pictures}
\createfigurel{../Individual-BD-SCH-Pictures/Figures/main-unit-pic-1.jpeg}{Main unit Picture 1}{fig:main-unit-pic-1}
\createfigurel{../Individual-BD-SCH-Pictures/Figures/main-unit-pic-2.jpeg}{Main unit Picture 2}{fig:main-unit-pic-2}
\subsection{Sub Unit}
\subsubsection{Block Diagrams}
\createfigurewsvg{../BDv5/Figures/bdv5-sub.svg}{Sub Unit Architectural Block Diagram}{fig:sub-bd-indv}
\subsubsection{Schematics}
\begin{landscape}
  \begin{center}
  \begin{figure}[H]
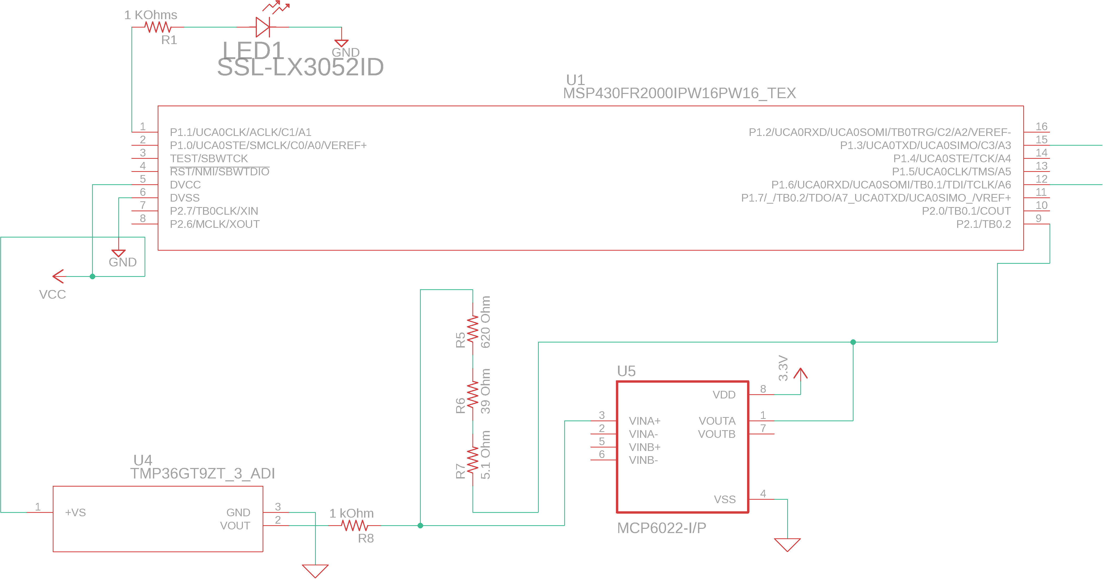
[picture p16: PROTOTYPE INTEGRATION and System Updates/System-Schematic-Diagrams/Figures/sub-unit.png]
    
    \caption{Sub Unit Schematic}
    \label{fig:sub-unit-schematic}
  \end{figure}
  \end{center}
\end{landscape}
\subsubsection{Pictures}
\createfigurel{../Individual-BD-SCH-Pictures/Figures/sub-unit-pic.jpeg}{Sub Unit Picture}{fig:sub-unit-pic}
  \subsection{Power Supply}
\subsubsection{Block Diagrams}
\createfigurewsvg{../Individual-BD-SCH-Pictures/Figures/main-unit-psu.svg}{Main Unit PSU Architectural Block Diagram}{fig:main-psu-bd-indv}
\createfigurewsvg{../Individual-BD-SCH-Pictures/Figures/sub-unit-psu.svg}{Sub Unit PSU Architectural Block Diagram}{fig:sub-psu-bd-indv}
\subsubsection{Schematics}
\begin{landscape}
  \begin{center}
  \begin{figure}[H]
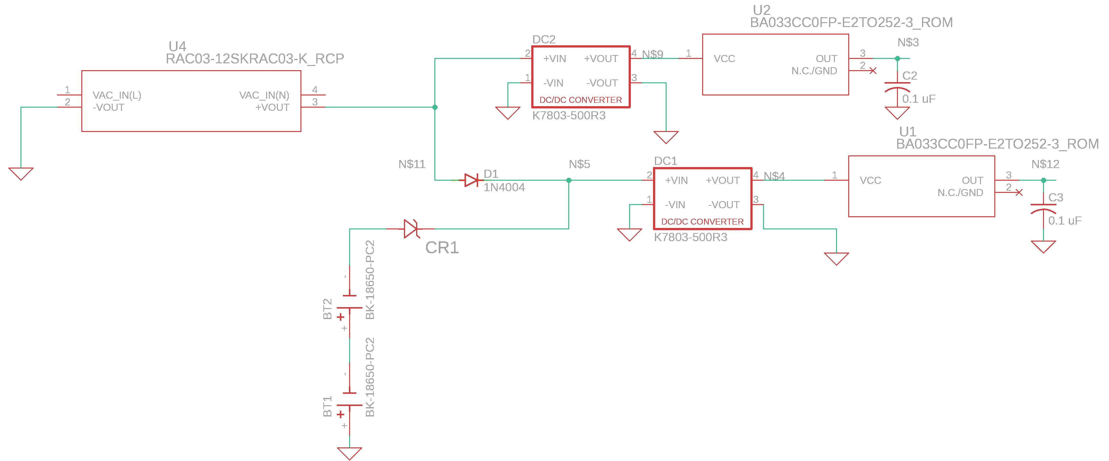
[picture p17: PROTOTYPE INTEGRATION and System Updates/System-Schematic-Diagrams/Figures/main-unit-psu.png]
    
    \caption{Main Unit PSU Schematic}
    \label{fig:main-psu-schematic}
  \end{figure}
  \end{center}
\createfigurew{../System-Schematic-Diagrams/Figures/sub-unit-psu.png}{Sub Unit PSU Schematic}{fig:sub-psu-schematic}
\end{landscape}
\subsubsection{Pictures}
\createfigurew{../Individual-BD-SCH-Pictures/Figures/main-unit-3.3V-1.jpeg}{Main unit PSU 3.3V Output Picture 1}{fig:main-unit-psu-1}
\createfigurew{../Individual-BD-SCH-Pictures/Figures/main-unit-3.3V-1.jpeg}{Main unit PSU 3.3V Output Picture 2}{fig:main-unit-psu-2}
\createfigurew{../Individual-BD-SCH-Pictures/Figures/main-unit-4V.jpeg}{Main unit PSU 4V Output Picture}{fig:main-unit-psu-3}
\createfigurew{../Individual-BD-SCH-Pictures/Figures/sub-unit-3.3V.jpeg}{Sub unit PSU 3.3V Output Picture}{fig:sub-unit-psu-1}
\createfigurew{../Individual-BD-SCH-Pictures/Figures/sub-unit-4V.jpeg}{Sub unit PSU 4V Output Picture}{fig:sub-unit-psu-2}
