fabiomatos999/ICOM-4217-Project/Microprocessor Selection and BDV2/Title-Page/title-page.tex

\begin{titlepage}
  \begin{center}
    \large{University of Puerto Rico\\
    Mayagüez Campus\\
    \vspace{\baselineskip}
    Department of Electrical and Computer Engineering\\}
    \vspace{6cm}
    \Huge{\underline{Insulin Temperature Warning System}\\}
    \vspace{0.5\baselineskip}
    \large by\\
    Fabio J. Matos Nieves\\
    Enrique Chompré\\
    Guillermo Colón\\
    Rubén Marrero\\
    \vspace{4cm}
    For: Professor Manuel Jimenez\\
    Course: INEL 4217 Seccion 096\\
    Date: Febuary 16, 2023\\
    \normalsize

  \end{center}
\end{titlepage}
