fabiomatos999/ICOM-4217-Project/Proposal/Market-Description/market-description.pdf

Features | Our Design | Fridge-tag® 2 L
What is this device monitoring? | Monitoring of insulin | Monitoring of sensitive vaccines and pharmaceuticals
If Temperature deviates: | More than 15C°, sets timer for maximum shelf-life of 2 weeks. Less than 0C° or more than 30C°, notifies that the product is no longer usable. | Gives an Alarm
Reset Button | Yes | Yes
Price | $28 (Approximate Build Price) | $149.00 (Commercial Price)
Battery is replaceable? | Yes | No
Battery Life | At least 2 Years | 3 Years
Is Battery Rechargeable? | Yes (Lithium) | No
Log | Yes (Per Batch) | Yes
USB Port | No | Yes, Automatically Generates 60 Day PDF Report when Connected to PC or Mac
Communication System | Yes (Via Bluetooth) | No
Display | Yes, instead of using an LCD display, we opted for the use of an application that will display the log / data via Bluetooth. | Yes, a custom display with more features.
Manipulation | It is programmable and can be manipulated to a certain degree. i.e. Battery or Memory. | Fridge-tag 2 L cannot be manipulated, reset or turned off without destroying it.
Log conversion to PDF | Yes, an app will have the ability to convert all log files to PDF on command | Yes
