fabiomatos999/ICOM-4217-Project/Hardware Design and System Updates/Detailed-Software-Plan/detailed-software-plan.tex

\section{Detailed Software Plan}
\subsection{Main Unit Software Plan}
  \begin{center}
  \begin{figure}[H]
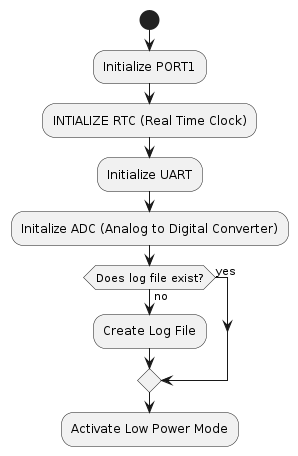
[picture p29: Hardware Design and System Updates/Software-Plan/main-unit-main-function.png]
    \centering 
    \caption{Main Unit Main Function}
    \label{fig:main-main}
  \end{figure}
  \end{center}
\createfigurew{../Software-Plan/main-unit-rtc-isr.png}{Main Unit RTC ISR}{fig:main-rtc-isr}
\createfigurew{../Software-Plan/main-unit-bluetooth-isr.png}{Main Unit Bluetooth ISR}{fig:main-bluetooth-isr}
\input{../Software-Plan/fsd-main-unit.tex}
\subsection{Sub Unit Software Plan}
\createfigurel{../Software-Plan/software-plan-sub-unit-main.png}{Sub Unit Main Function}{fig:sub-main}
\createfigurew{../Software-Plan/software-plan-sub-unit-rtc-isr.png}{Sub Unit RTC ISR}{fig:sub-rtc-isr}
\input{../Software-Plan/fsd-sub-unit.tex}
