fabiomatos999/ICOM-4217-Project/Hardware Design and System Updates/Software-Plan/software-plan-sub-unit-main.tex

% PSTricks TeX macro
% Title: C:\Users\uwu\Documents\GitHub Repos\ICOM-4217-Project\Hardware Design and System Updates\Software Plan\software-plan-sub-unit-main
% Creator: Dia v0.97.2
% CreationDate: Fri Mar 03 11:08:23 2023
% For: uwu
% \usepackage{pstricks}
% The following commands are not supported in PSTricks at present
% We define them conditionally, so when they are implemented,
% this pstricks file will use them.
\ifx\setlinejoinmode\undefined
  \newcommand{\setlinejoinmode}[1]{}
\fi
\ifx\setlinecaps\undefined
  \newcommand{\setlinecaps}[1]{}
\fi
% This way define your own fonts mapping (for example with ifthen)
\ifx\setfont\undefined
  \newcommand{\setfont}[2]{}
\fi
\pspicture(18.300000,-36.200000)(30.250000,-5.150000)
\psscalebox{1.000000 -1.000000}{
\newrgbcolor{dialinecolor}{0.000000 0.000000 0.000000}%
\psset{linecolor=dialinecolor}
\newrgbcolor{diafillcolor}{1.000000 1.000000 1.000000}%
\psset{fillcolor=diafillcolor}
\psset{linewidth=0.100000cm}
\psset{linestyle=solid}
\psset{linestyle=solid}
\setlinecaps{0}
\setlinejoinmode{0}
\psset{linewidth=0.100000cm}
\setlinecaps{0}
\setlinejoinmode{0}
\psset{linestyle=solid}
\newrgbcolor{dialinecolor}{1.000000 1.000000 1.000000}%
\psset{linecolor=dialinecolor}
\pscustom{
\newpath
\moveto(20.325000,5.200000)
\lineto(28.225000,5.200000)
\curveto(29.315763,5.200000)(30.200000,5.647715)(30.200000,6.200000)
\curveto(30.200000,6.752285)(29.315763,7.200000)(28.225000,7.200000)
\lineto(20.325000,7.200000)
\curveto(19.234237,7.200000)(18.350000,6.752285)(18.350000,6.200000)
\curveto(18.350000,5.647715)(19.234237,5.200000)(20.325000,5.200000)
\fill[fillstyle=solid,fillcolor=diafillcolor,linecolor=diafillcolor]}
\newrgbcolor{dialinecolor}{0.000000 0.000000 0.000000}%
\psset{linecolor=dialinecolor}
\pscustom{
\newpath
\moveto(20.325000,5.200000)
\lineto(28.225000,5.200000)
\curveto(29.315763,5.200000)(30.200000,5.647715)(30.200000,6.200000)
\curveto(30.200000,6.752285)(29.315763,7.200000)(28.225000,7.200000)
\lineto(20.325000,7.200000)
\curveto(19.234237,7.200000)(18.350000,6.752285)(18.350000,6.200000)
\curveto(18.350000,5.647715)(19.234237,5.200000)(20.325000,5.200000)
\stroke}
\setfont{Helvetica}{0.800000}
\newrgbcolor{dialinecolor}{0.000000 0.000000 0.000000}%
\psset{linecolor=dialinecolor}
\rput(24.275000,6.440000){\psscalebox{1 -1}{Main Start}}
\newrgbcolor{dialinecolor}{1.000000 1.000000 1.000000}%
\psset{linecolor=dialinecolor}
\pspolygon*(20.535800,9.973290)(20.535800,11.973290)(27.979550,11.973290)(27.979550,9.973290)
\psset{linewidth=0.100000cm}
\psset{linestyle=solid}
\psset{linestyle=solid}
\setlinejoinmode{0}
\newrgbcolor{dialinecolor}{0.000000 0.000000 0.000000}%
\psset{linecolor=dialinecolor}
\pspolygon(20.535800,9.973290)(20.535800,11.973290)(27.979550,11.973290)(27.979550,9.973290)
\setfont{Helvetica}{0.800000}
\newrgbcolor{dialinecolor}{0.000000 0.000000 0.000000}%
\psset{linecolor=dialinecolor}
\rput(24.257675,11.213290){\psscalebox{1 -1}{Initialize Port1 }}
\psset{linewidth=0.100000cm}
\psset{linestyle=solid}
\psset{linestyle=solid}
\setlinecaps{0}
\newrgbcolor{dialinecolor}{0.000000 0.000000 0.000000}%
\psset{linecolor=dialinecolor}
\psline(24.275000,7.200000)(24.260737,9.486496)
\psset{linestyle=solid}
\setlinejoinmode{0}
\setlinecaps{0}
\newrgbcolor{dialinecolor}{0.000000 0.000000 0.000000}%
\psset{linecolor=dialinecolor}
\pspolygon*(24.258397,9.861489)(24.011521,9.359939)(24.260737,9.486496)(24.511512,9.363058)
\newrgbcolor{dialinecolor}{0.000000 0.000000 0.000000}%
\psset{linecolor=dialinecolor}
\pspolygon(24.258397,9.861489)(24.011521,9.359939)(24.260737,9.486496)(24.511512,9.363058)
\newrgbcolor{dialinecolor}{1.000000 1.000000 1.000000}%
\psset{linecolor=dialinecolor}
\pspolygon*(18.437400,14.865900)(18.437400,16.765900)(30.114900,16.765900)(30.114900,14.865900)
\psset{linewidth=0.100000cm}
\psset{linestyle=solid}
\psset{linestyle=solid}
\setlinejoinmode{0}
\newrgbcolor{dialinecolor}{0.000000 0.000000 0.000000}%
\psset{linecolor=dialinecolor}
\pspolygon(18.437400,14.865900)(18.437400,16.765900)(30.114900,16.765900)(30.114900,14.865900)
\setfont{Helvetica}{0.800000}
\newrgbcolor{dialinecolor}{0.000000 0.000000 0.000000}%
\psset{linecolor=dialinecolor}
\rput(24.276150,16.055900){\psscalebox{1 -1}{Initialize internal Temperature sensor}}
\newrgbcolor{dialinecolor}{1.000000 1.000000 1.000000}%
\psset{linecolor=dialinecolor}
\pspolygon*(21.428900,19.190400)(21.428900,21.090400)(26.666400,21.090400)(26.666400,19.190400)
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
\fill[fillstyle=solid,fillcolor=diafillcolor,linecolor=diafillcolor]}
\newrgbcolor{dialinecolor}{0.000000 0.000000 0.000000}%
\psset{linecolor=dialinecolor}
\pscustom{
\newpath
\moveto(20.367500,34.150000)
\lineto(27.932500,34.150000)
\curveto(28.977009,34.150000)(29.823750,34.597715)(29.823750,35.150000)
\curveto(29.823750,35.702285)(28.977009,36.150000)(27.932500,36.150000)
\lineto(20.367500,36.150000)
\curveto(19.322991,36.150000)(18.476250,35.702285)(18.476250,35.150000)
\curveto(18.476250,34.597715)(19.322991,34.150000)(20.367500,34.150000)
\stroke}
\setfont{Helvetica}{0.800000}
\newrgbcolor{dialinecolor}{0.000000 0.000000 0.000000}%
\psset{linecolor=dialinecolor}
\rput(24.150000,35.400000){\psscalebox{1 -1}{Activate Low Power Mode}}
}\endpspicture
