fabiomatos999/ICOM-4217-Project/Hardware Design and System Updates/Software-Plan/software-plan-sub-unit-rtc-isr.tex

% PSTricks TeX macro
% Title: C:\Users\uwu\Documents\GitHub Repos\ICOM-4217-Project\Hardware Design and System Updates\Software Plan\software-plan-sub-unit-rtc-isr
% Creator: Dia v0.97.2
% CreationDate: Fri Mar 03 11:00:28 2023
% For: uwu
% \usepackage{pstricks}
% The following commands are not supported in PSTricks at present
% We define them conditionally, so when they are implemented,
% this pstricks file will use them.
\ifx\setlinejoinmode\undefined
  \newcommand{\setlinejoinmode}[1]{}
\fi
\ifx\setlinecaps\undefined
  \newcommand{\setlinecaps}[1]{}
\fi
% This way define your own fonts mapping (for example with ifthen)
\ifx\setfont\undefined
  \newcommand{\setfont}[2]{}
\fi
\pspicture(28.340800,-55.016058)(93.887646,-0.986080)
\psscalebox{1.000000 -1.000000}{
\newrgbcolor{dialinecolor}{0.000000 0.000000 0.000000}%
\psset{linecolor=dialinecolor}
\newrgbcolor{diafillcolor}{1.000000 1.000000 1.000000}%
\psset{fillcolor=diafillcolor}
\psset{linewidth=0.100000cm}
\psset{linestyle=solid}
\psset{linestyle=solid}
\setlinecaps{0}
\setlinejoinmode{0}
\psset{linewidth=0.100000cm}
\setlinecaps{0}
\setlinejoinmode{0}
\psset{linestyle=solid}
\newrgbcolor{dialinecolor}{1.000000 1.000000 1.000000}%
\psset{linecolor=dialinecolor}
\pscustom{
\newpath
\moveto(33.260825,1.036080)
\lineto(36.063325,1.036080)
\curveto(36.450270,1.036080)(36.763950,1.483795)(36.763950,2.036080)
\curveto(36.763950,2.588365)(36.450270,3.036080)(36.063325,3.036080)
\lineto(33.260825,3.036080)
\curveto(32.873880,3.036080)(32.560200,2.588365)(32.560200,2.036080)
\curveto(32.560200,1.483795)(32.873880,1.036080)(33.260825,1.036080)
\fill[fillstyle=solid,fillcolor=diafillcolor,linecolor=diafillcolor]}
\newrgbcolor{dialinecolor}{0.000000 0.000000 0.000000}%
\psset{linecolor=dialinecolor}
\pscustom{
\newpath
\moveto(33.260825,1.036080)
\lineto(36.063325,1.036080)
\curveto(36.450270,1.036080)(36.763950,1.483795)(36.763950,2.036080)
\curveto(36.763950,2.588365)(36.450270,3.036080)(36.063325,3.036080)
\lineto(33.260825,3.036080)
\curveto(32.873880,3.036080)(32.560200,2.588365)(32.560200,2.036080)
\curveto(32.560200,1.483795)(32.873880,1.036080)(33.260825,1.036080)
\stroke}
\setfont{Helvetica}{0.800000}
\newrgbcolor{dialinecolor}{0.000000 0.000000 0.000000}%
\psset{linecolor=dialinecolor}
\rput(34.662075,2.276080){\psscalebox{1 -1}{RTC\_ISR}}
\newrgbcolor{dialinecolor}{1.000000 1.000000 1.000000}%
\psset{linecolor=dialinecolor}
\pspolygon*(34.733960,5.719610)(41.077120,8.891190)(34.733960,12.062770)(28.390800,8.891190)
\psset{linewidth=0.100000cm}
\psset{linestyle=solid}
\psset{linestyle=solid}
\setlinejoinmode{0}
\newrgbcolor{dialinecolor}{0.000000 0.000000 0.000000}%
\psset{linecolor=dialinecolor}
\pspolygon(34.733960,5.719610)(41.077120,8.891190)(34.733960,12.062770)(28.390800,8.891190)
\setfont{Helvetica}{0.800000}
\newrgbcolor{dialinecolor}{0.000000 0.000000 0.000000}%
\psset{linecolor=dialinecolor}
\rput(34.733960,9.131190){\psscalebox{1 -1}{2 °C <= CURR\_TEMP <= 8 °C}}
\psset{linewidth=0.100000cm}
\psset{linestyle=solid}
\psset{linestyle=solid}
\setlinecaps{0}
\newrgbcolor{dialinecolor}{0.000000 0.000000 0.000000}%
\psset{linecolor=dialinecolor}
\psline(34.662000,3.036080)(34.720944,5.232982)
\psset{linestyle=solid}
\setlinejoinmode{0}
\setlinecaps{0}
\newrgbcolor{dialinecolor}{0.000000 0.000000 0.000000}%
\psset{linecolor=dialinecolor}
\pspolygon*(34.731001,5.607847)(34.467681,5.114732)(34.720944,5.232982)(34.967501,5.101322)
\newrgbcolor{dialinecolor}{0.000000 0.000000 0.000000}%
\psset{linecolor=dialinecolor}
\pspolygon(34.731001,5.607847)(34.467681,5.114732)(34.720944,5.232982)(34.967501,5.101322)
\psset{linewidth=0.100000cm}
\psset{linestyle=solid}
\psset{linestyle=solid}
\setlinecaps{0}
\newrgbcolor{dialinecolor}{0.000000 0.000000 0.000000}%
\psset{linecolor=dialinecolor}
\psline(34.734000,12.062800)(34.750433,14.853405)
\psset{linestyle=solid}
\setlinejoinmode{0}
\setlinecaps{0}
\newrgbcolor{dialinecolor}{0.000000 0.000000 0.000000}%
\psset{linecolor=dialinecolor}
\pspolygon*(34.752642,15.228399)(34.499702,14.729879)(34.750433,14.853405)(34.999693,14.726935)
\newrgbcolor{dialinecolor}{0.000000 0.000000 0.000000}%
\psset{linecolor=dialinecolor}
\pspolygon(34.752642,15.228399)(34.499702,14.729879)(34.750433,14.853405)(34.999693,14.726935)
\setfont{Helvetica}{0.800000}
\newrgbcolor{dialinecolor}{0.000000 0.000000 0.000000}%
\psset{linecolor=dialinecolor}
\rput[l](35.379800,13.797900){\psscalebox{1 -1}{Yes}}
\psset{linewidth=0.100000cm}
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
\psset{linecolor=dialinecolor}
\rput(34.820582,54.216058){\psscalebox{1 -1}{RETI}}
\psset{linewidth=0.100000cm}
\psset{linestyle=solid}
\psset{linestyle=solid}
\setlinecaps{0}
\newrgbcolor{dialinecolor}{0.000000 0.000000 0.000000}%
\psset{linecolor=dialinecolor}
\psline(34.766057,48.849406)(34.814135,52.479297)
\psset{linestyle=solid}
\setlinejoinmode{0}
\setlinecaps{0}
\newrgbcolor{dialinecolor}{0.000000 0.000000 0.000000}%
\psset{linecolor=dialinecolor}
\pspolygon*(34.819101,52.854264)(34.562501,52.357619)(34.814135,52.479297)(35.062458,52.350997)
\newrgbcolor{dialinecolor}{0.000000 0.000000 0.000000}%
\psset{linecolor=dialinecolor}
\pspolygon(34.819101,52.854264)(34.562501,52.357619)(34.814135,52.479297)(35.062458,52.350997)
\setfont{Helvetica}{0.800000}
\newrgbcolor{dialinecolor}{0.000000 0.000000 0.000000}%
\psset{linecolor=dialinecolor}
\rput[l](71.279845,38.399977){\psscalebox{1 -1}{No}}
}\endpspicture
