fabiomatos999/ICOM-4217-Project/Proposal/Appendices/appendices.tex

\section{Appendices}
\begin{figure}[H]
  \centering
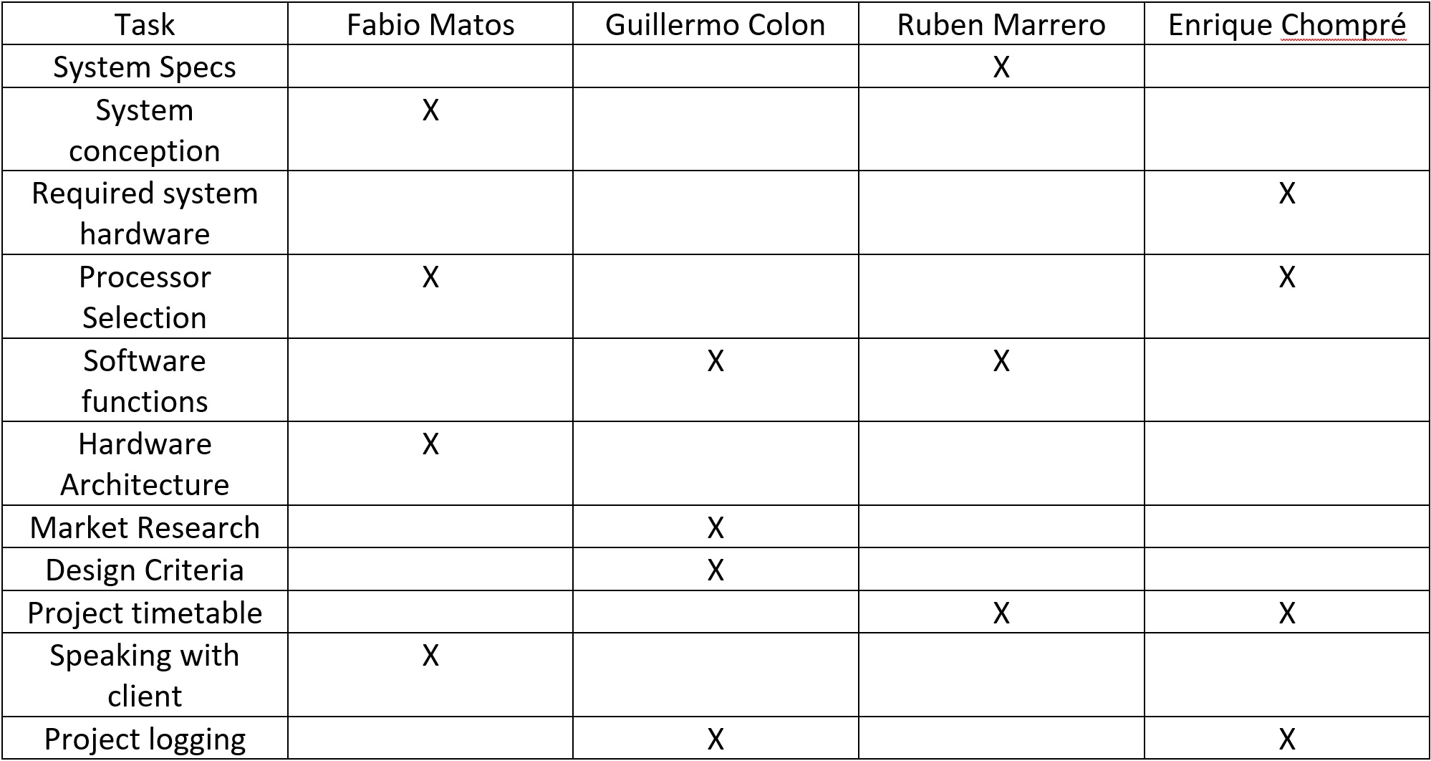
[picture p30: Proposal/Appendices/Figures/work-distrobution-table.jpeg]
  
  \caption{Work Distribution Table}
\end{figure}
Work Distribution Table

Project Journal 
January 21, 2023 at 3:00pm: First team meeting where all members where present. Discussed initial proposal ideas, potential clients and started work on pre-proposals to be sent for review.

January 28, 2023 at 1:00pm: Team meeting with all team members present. Team leader fixed their proposal while other team members searched for new ideas with new clients. Discussed several ideas and reached new ideas and new clients where the rest of the team members continued to develop. Also ranked all ideas and provided details for each proposal. Also started work on proposal document to be sent. Each team member assigned a part to do once an idea was selected after pre-proposal review. 

January 29, 2023 at 6:00pm: Small meeting between team leader Fabio Matos and team member Enrique Chompré. Discussed new idea for proposal and new client. Finished new pre-proposal document for review.
