fabiomatos999/ICOM-4217-Project/Proposal/System-Conception/system-conception.tex

\section{System Conception}
\begin{figure}[H]
  \centering
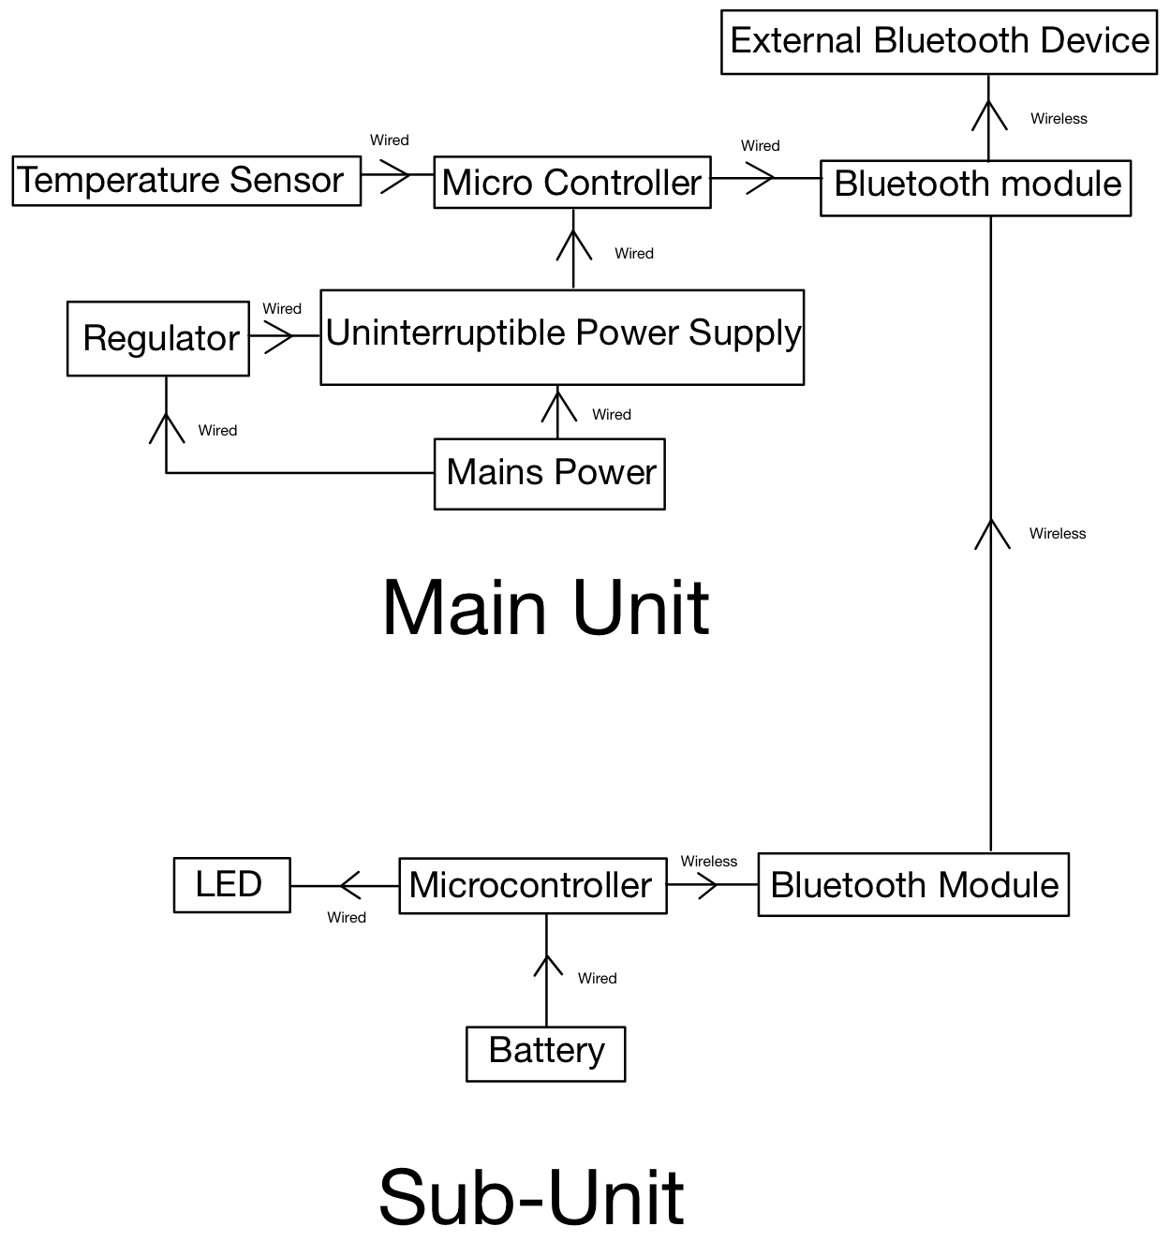
[picture p31: Proposal/System-Conception/Figures/global-system-view.png]
  
  \caption{Global System View}
\end{figure}
\begin{figure}[H]
  \centering
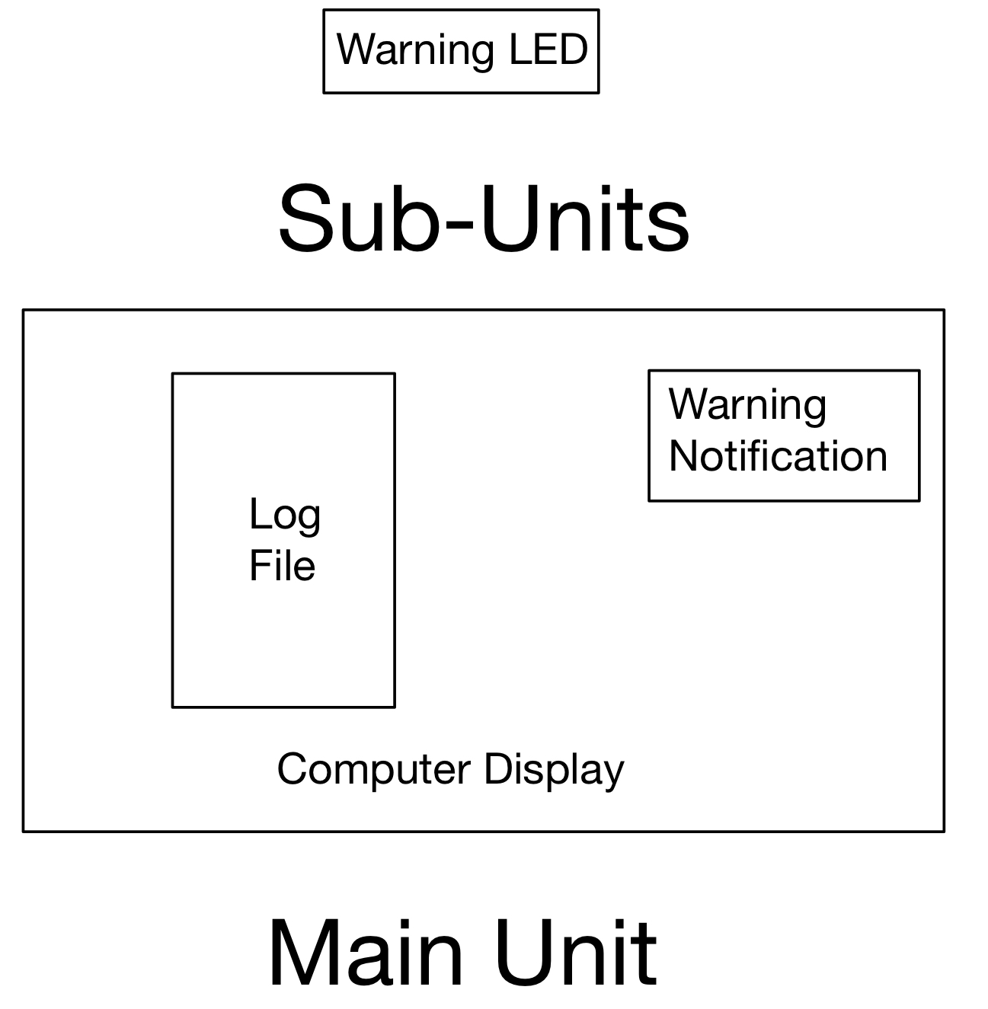
[picture p32: Proposal/System-Conception/Figures/user-interface-level.png]
  
  \caption{User Interface Level}
\end{figure}
\section{System Architecture and Functionality}
\begin{figure}[H]
  \centering
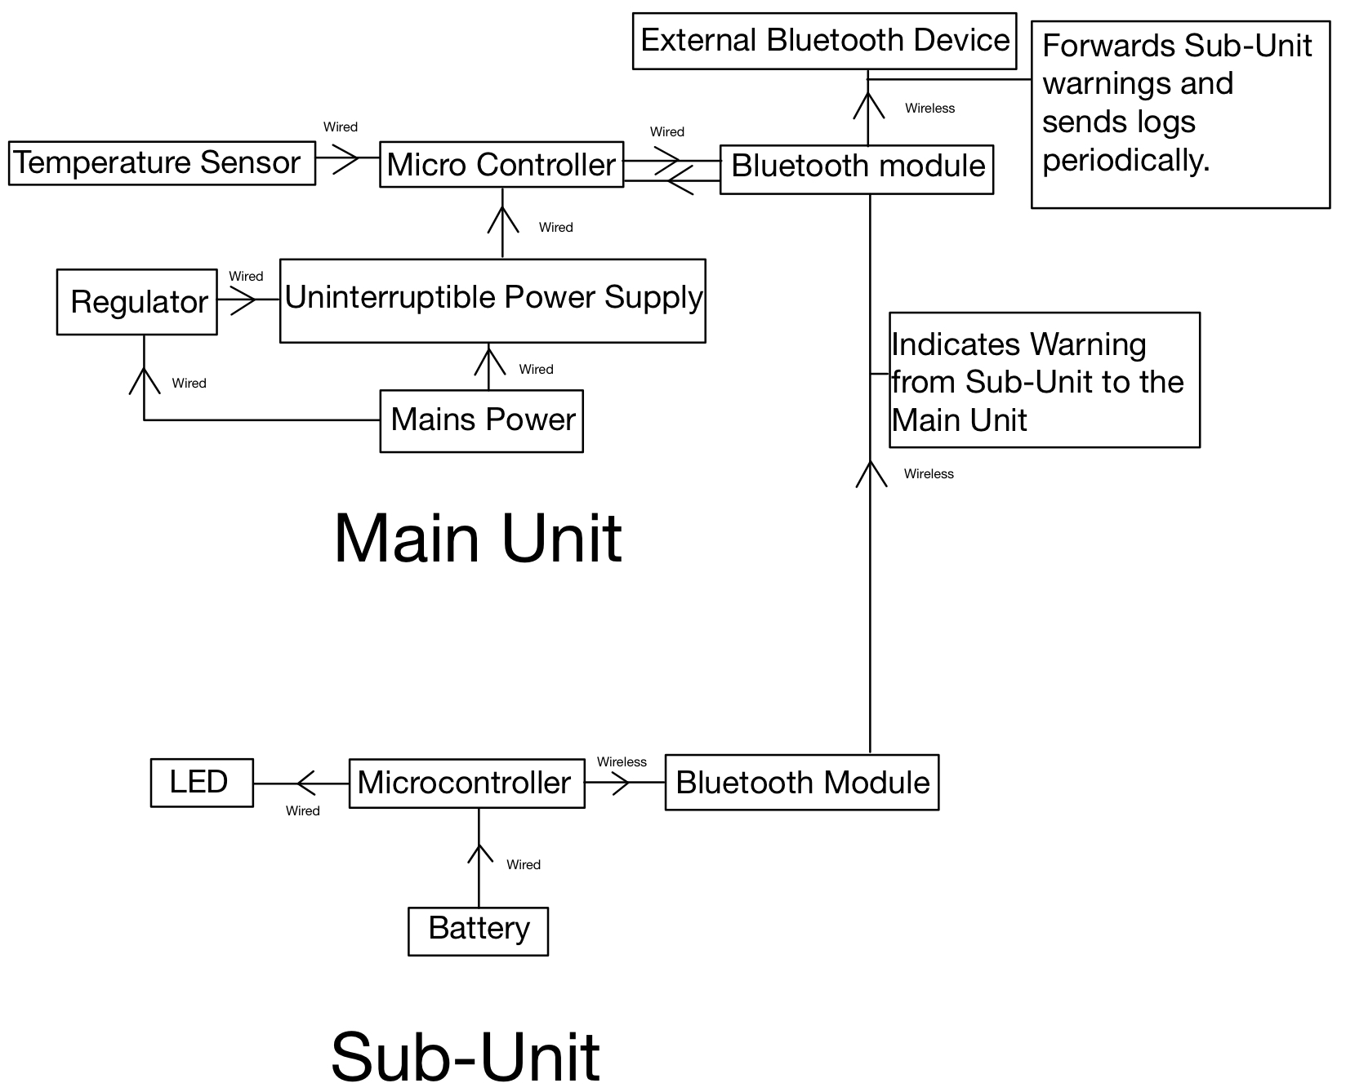
[picture p33: Proposal/System-Architecture-and-Functionality/Figures/system-architecture-block-diagram.png]
  
  \caption{System Architecture Block Diagram}
\end{figure}
