fabiomatos999/ICOM-4217-Project/PROTOTYPE INTEGRATION and System Updates/Completion-Table/completion-table.tex

\section{Completion Table}
\begin{table}[h]
 \begin{center}
  \begin{tabular}{|c|c|c|}
    \hline
    \multicolumn{3}{|c|}{Completion Table}\\
    \hline
    Module&Hardware Completion (\%)&Software Completion (\%)\\
    \hline
    Main Unit&100\%&90\%\\
    \hline
    Sub Unit&100\%&95\%\\
    \hline
    Power Supply (PSU)&100\%&-\\
    \hline
    Host Computer Software&-&0\%\\
    \hline
  \end{tabular}
 \end{center}
 \caption{Module Completion Table}
 \label{tab:comp-table}
\end{table}
