fabiomatos999/ICOM-4217-Project/Hardware Design and System Updates/Updated-Project-Poster/updated-project-poster.pdf

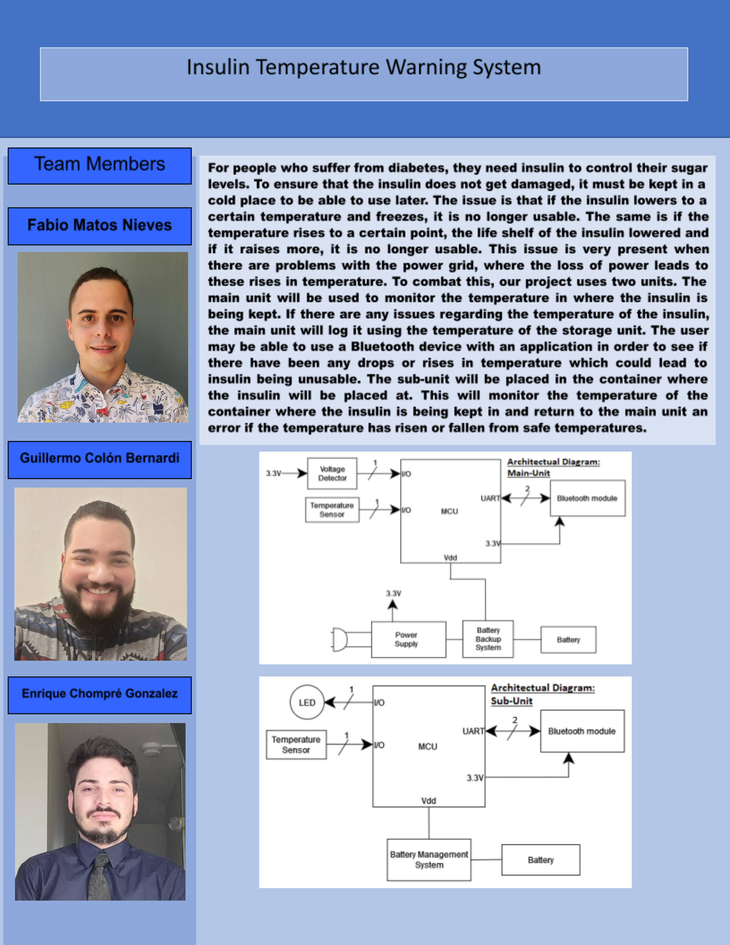
[picture p34: page 1]
