fabiomatos999/ICOM-4217-Project/Proposal/Project-Time-Table/project-time-table.xlsx

Sheet: ProjectSchedule
Create a Project Schedule in this worksheet. Enter title of this project in cell B1. Information about how to use this worksheet, including instructions for screen readers and the author of this workbook is in the About worksheet. Continue navigating down column A to hear further instructions. | Project Time Table
Enter Company Name in cell B2.
Enter the name of the Project Lead in cell B3. Enter the Project Start date in cell E3. Project Start: label is in cell C3. | Group 1 | Project Start: |  | 2023-02-02
The Display Week in cell E4 represents the starting week to display in the project schedule in cell I4. The project start date is considered Week 1. To change the display week, simply enter a new week number in cell E4. The starting date for each week, starting with the display week from cell E4, starts in cell I4 and is auto calculated. There are 8 weeks represented in this view from cell I4 through cell BF4. You should not modify these cells. Display Week: label is in cell C4. |  | Display Week: |  | 1 |  | 2023-01-31 |  |  |  |  |  |  | 2023-02-06 |  |  |  |  |  |  | 2023-02-13 |  |  |  |  |  |  | 2023-02-20 |  |  |  |  |  |  | 2023-02-27 |  |  |  |  |  |  | 2023-03-06 |  |  |  |  |  |  | 2023-03-13 |  |  |  |  |  |  | 2023-03-20
Cells I5 through BL5 contain the day number for the week represented in the cell block above each date cell and are auto calculated. You should not modify these cells. Today's date is outlined in Red (hex #AD3815) from today's date in row 5 through the entire date column to the end of the project schedule. |  |  |  |  |  | 2023-01-30 | 2023-01-31 | 2023-02-01 | 2023-02-02 | 2023-02-03 | 2023-02-04 | 2023-02-05 | 2023-02-06 | 2023-02-07 | 2023-02-08 | 2023-02-09 | 2023-02-10 | 2023-02-11 | 2023-02-12 | 2023-02-13 | 2023-02-14 | 2023-02-15 | 2023-02-16 | 2023-02-17 | 2023-02-18 | 2023-02-19 | 2023-02-20 | 2023-02-21 | 2023-02-22 | 2023-02-23 | 2023-02-24 | 2023-02-25 | 2023-02-26 | 2023-02-27 | 2023-02-28 | 2023-03-01 | 2023-03-02 | 2023-03-03 | 2023-03-04 | 2023-03-05 | 2023-03-06 | 2023-03-07 | 2023-03-08 | 2023-03-09 | 2023-03-10 | 2023-03-11 | 2023-03-12 | 2023-03-13 | 2023-03-14 | 2023-03-15 | 2023-03-16 | 2023-03-17 | 2023-03-18 | 2023-03-19 | 2023-03-20 | 2023-03-21 | 2023-03-22
This row contains headers for the project schedule that follows below them. Navigate from B6 through BL 6 to hear the content. The first letter of each day of the week for the date above that heading, starts in cell I6 and continues through cell BL6. All project timeline charting is auto generated based on the start and end dates entered, using conditional formats. Do not modify content in cells within columns after column I starting with cell I7. | TASK | ASSIGNED TO | PROGRESS | START | END | M | T | W | T | F | S | S | M | T | W | T | F | S | S | M | T | W | T | F | S | S | M | T | W | T | F | S | S | M | T | W | T | F | S | S | M | T | W | T | F | S | S | M | T | W | T | F | S | S | M | T | W
Cell B8 contains the Phase 1 sample title. Enter a new Title in cell B8. Enter a name to assign the phase to, if it applies for your project, in cell C8. Enter Progress for the entire phase, if it applies for your project, in cell D8. Enter the start and end dates for the entire phase, if it applies for your project, in cells E8 and F8. The Gantt chart will automatically fill in the appropriate dates and shade according to the progress entered. To delete the phase and work only from tasks, simply delete this row. | Problem definition and specifications | Group 1
Cell B9 contains the sample task "Task 1." Enter a new task name in cell B9. Enter a person to assign the task to in cell C9. Enter progress of the task in cell D9. A progress bar appears in the cell and is shaded according to the number in the cell. For example, 50 percent progress would shade half of the cell. Enter task start date in cell E9. Enter task end date in cell F9. A status bar shaded for the dates entered appears in blocks starting from cell I9 through BL9. | Defined problem provided |  | 100% | 2023-02-02 | 2023-02-03
Rows 10 through 13 repeat the pattern from row 9. Repeat the instructions from cell A9 for all task rows in this worksheet. Overwrite any sample data. A sample of another phase starts in cell A14. Continue entering tasks in cells A10 through A13 or go to cell A14 to learn more. | Hardware specifications |  | 100% | 2023-02-03 | 2023-02-03
 | Software specifications |  | 100% | 2023-02-03 | 2023-02-03
The cell at right contains the Phase 2 sample title. You can create a new phase at any time within column B. This project schedule does not require phases. To remove the phase, simply delete the row. To create a new phase block in this row, enter a new Title in cell at right. To continue adding tasks to the phase above, enter a new row above this one and fill in the task data as in cell A9's instruction. Update the Phase details in cell at right based on cell A8's instruction. Continue navigating down column A cells to learn more. If you haven't added any new rows in this worksheet, you will find 2 additional sample phase blocks have been created for you in cells B20 and B26. Otherwise, navigate through column A cells to find the additional blocks. Repeat the instructions from cells A8 and A9 whenever you need to. | Architecture-level system design | Group 1
 | Detailed system block diagram |  | 0% | 2023-02-04 | 2023-02-16
 | Expected system lifecycle |  | 0% | 2023-02-04 | 2023-02-16
 | System operating flowchart |  | 0% | 2023-02-04 | 2023-02-16
 | Project Poster |  | 0% | 2023-02-04 | 2023-02-16
Sample phase title block | Hardware design and parts acquisition | Group 1
 | Bill of materials |  | 0% | 2023-02-17 | 2023-03-07
 | Schematic diagrams |  | 0% | 2023-02-17 | 2023-03-07
 | Power and timing Analyses |  | 0% | 2023-02-17 | 2023-03-07
 | Cost Analysis |  | 0% | 2023-02-17 | 2023-03-07
 | Final Poster |  | 0% | 2023-02-17 | 2023-03-07
 | Updated System Block Diagram |  | 0% | 2023-02-17 | 2023-03-07
Sample phase title block | Software design and coding | Group 1
 | Detailed Software plan |  | 0% | 2023-03-08 | 2023-04-11
 | Software early version |  | 0% | 2023-03-08 | 2023-04-11
 | Completion table for software |  | 0% | 2023-03-08 | 2023-04-11
 | Prototype integration, testing, and debugging | Group 1
 | Written SW/HW Desing updated |  | 0% | 2023-04-20 | 2023-04-20
 | Provide SW/HW Integration Table |  | 0% | 2023-04-20 | 2023-04-20
 | Provide demostration of integrated system funcionality |  | 0% | 2023-04-20 | 2023-04-20
 | Assemblage Plan and PCB Design |  | 0% | 2023-04-20 | 2023-04-20
 | Progress and Final Report preparation | Group 1
 | Evaluation of contribution |  | 0% | 2023-04-21 | 2023-05-04
 | Proper documentation |  | 0% | 2023-04-21 | 2023-05-04
 | Final report |  | 0% | 2023-04-21 | 2023-05-04
This row marks the end of the Project Schedule. DO NOT enter anything in this row. Insert new rows ABOVE this one to continue building out your Project Schedule. | Insert new rows ABOVE this one

Sheet: About
SIMPLE GANTT CHART by Vertex42.com (https://www.vertex42.com/ExcelTemplates/simple-gantt-chart.html)
https://www.vertex42.com/ExcelTemplates/simple-gantt-chart.html
About This Template
This template provides a simple way to create a Gantt chart to help visualize and track your project. Simply enter your tasks and start and end dates - no formulas required. The bars in the Gantt chart represent the duration of the task and are displayed using conditional formatting. Insert new tasks by inserting new rows.
Guide for Screen Readers
There are 2 worksheets in this workbook. TimeSheet About The instructions for each worksheet are in the A column starting in cell A1 of each worksheet. They are written with hidden text. Each step guides you through the information in that row. Each subsequent step continues in cell A2, A3, and so on, unless otherwise explicitly directed. For example, instruction text might say "continue to cell A6" for the next step. This hidden text will not print. To remove these instructions from the worksheet, simply delete column A.
Additional Help
Click on the link below to visit vertex42.com and learn more about how to use this template, such as how to calculate days and work days, create task dependencies, change the colors of the bars, add a scroll bar to make it easier to change the display week, extend the date range displayed in the chart, etc.
How to Use the Simple Gantt Chart (https://www.vertex42.com/ExcelTemplates/simple-gantt-chart.html)
More Project Management Templates
Visit Vertex42.com to download other project management templates, including different types of project schedules, Gantt charts, tasks lists, etc.
Project Management Templates (https://www.vertex42.com/ExcelTemplates/excel-project-management.html)
About Vertex42
Vertex42.com provides over 300 professionally designed spreadsheet templates for business, home, and education - most of which are free to download. Their collection includes a variety of calendars, planners, and schedules as well as personal finance spreadsheets for budgeting, debt reduction, and loan amortization.
Businesses will find invoices, time sheets, inventory trackers, financial statements, and project planning templates. Teachers and students will find resources such as class schedules, grade books, and attendance sheets. Organize your family life with meal planners, checklists, and exercise logs. Each template is thoroughly researched, refined, and improved over time through feedback from thousands of users.
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
