fabiomatos999/ICOM-4217-Project/Final Project Report/Modular Design/Main-Unit-PSU/Figures/main-unit-3.3V-2.jpeg

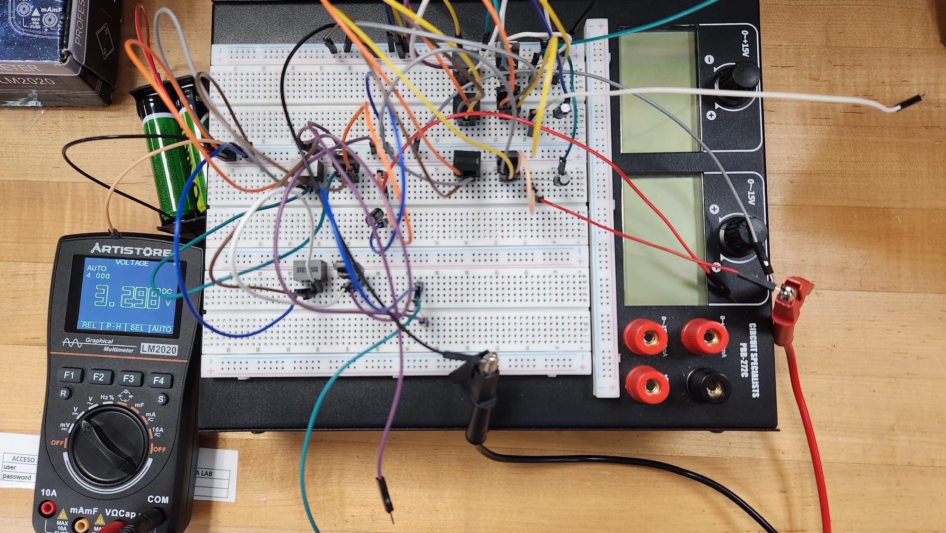
Final Project Report/Modular Design/Main-Unit-PSU/Figures/main-unit-3.3V-2.jpeg
