fabiomatos999/ICOM-4217-Project/Final Project Report/Modular Design/Main-Unit-PSU/Figures/main-unit-4V.jpeg

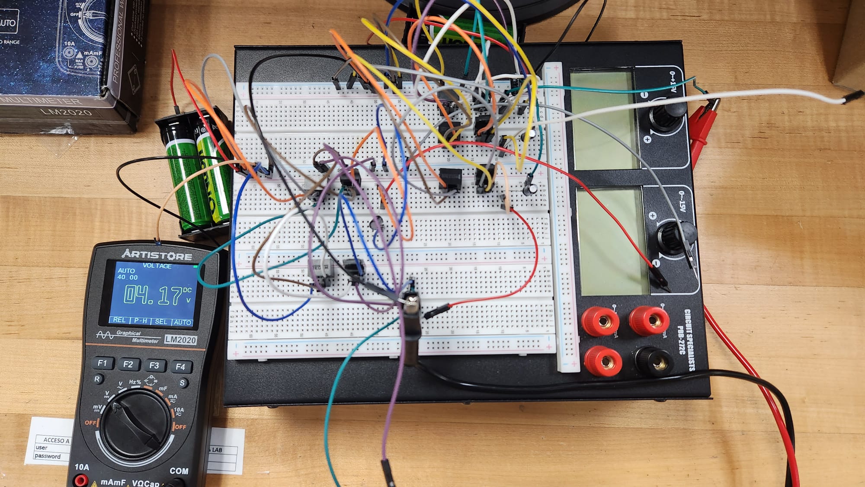
Final Project Report/Modular Design/Main-Unit-PSU/Figures/main-unit-4V.jpeg
