fabiomatos999/ICOM-4217-Project/Final Project Report/Modular Design/Main-Unit/Figures/main-unit-bluetooth-isr.png

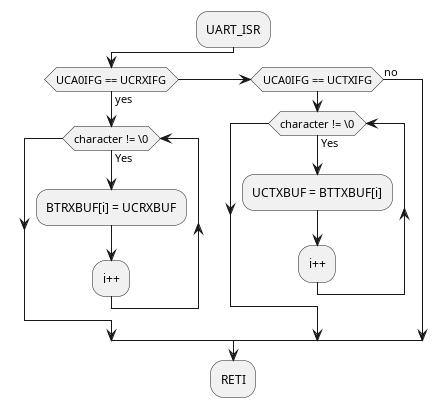
Final Project Report/Modular Design/Main-Unit/Figures/main-unit-bluetooth-isr.png
