fabiomatos999/ICOM-4217-Project/Final Project Report/Modular Design/Main-Unit/Figures/main-unit-main-function-pseudo-code.png

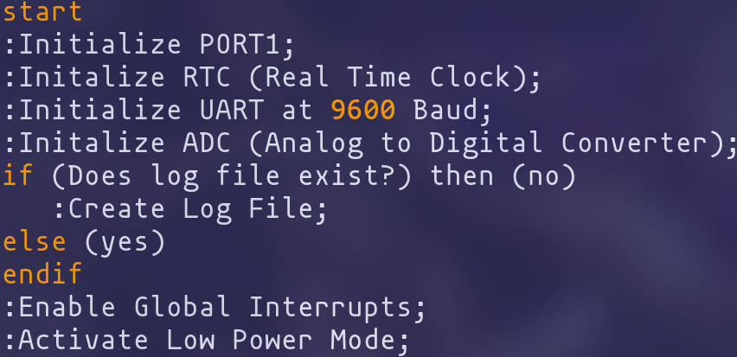
Final Project Report/Modular Design/Main-Unit/Figures/main-unit-main-function-pseudo-code.png
