fabiomatos999/ICOM-4217-Project/Final Project Report/Modular Design/Main-Unit/Figures/main-unit-pic-1.jpeg

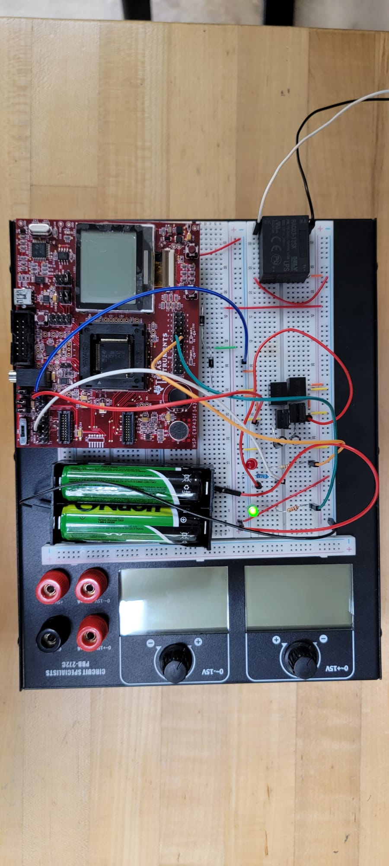
Final Project Report/Modular Design/Main-Unit/Figures/main-unit-pic-1.jpeg
