fabiomatos999/ICOM-4217-Project/Final Project Report/Modular Design/Main-Unit/Figures/main-unit-pic-2.jpeg

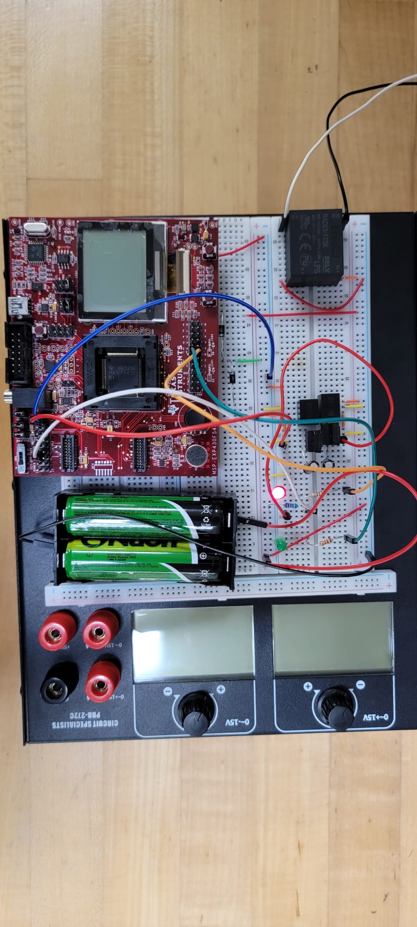
Final Project Report/Modular Design/Main-Unit/Figures/main-unit-pic-2.jpeg
