fabiomatos999/ICOM-4217-Project/Final Project Report/Modular Design/Sub-Unit-PSU/Figures/sub-unit-3.3V.jpeg

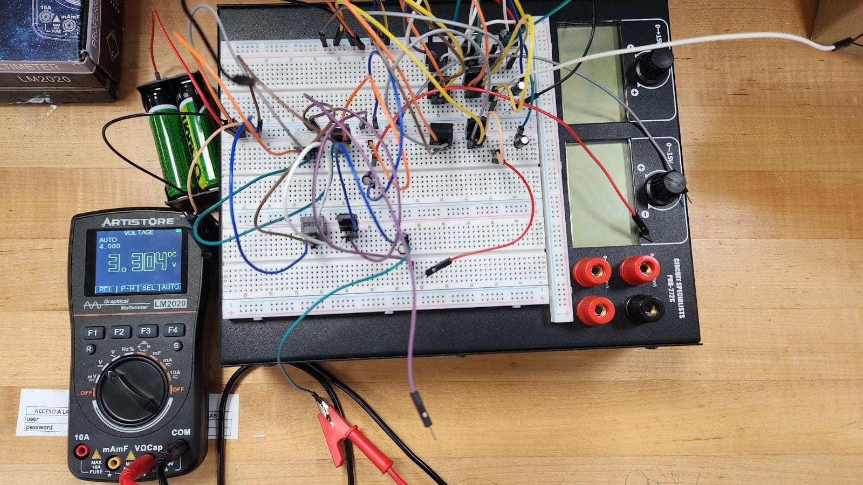
Final Project Report/Modular Design/Sub-Unit-PSU/Figures/sub-unit-3.3V.jpeg
