fabiomatos999/ICOM-4217-Project/Final Project Report/Modular Design/Sub-Unit-PSU/Figures/sub-unit-4V.jpeg

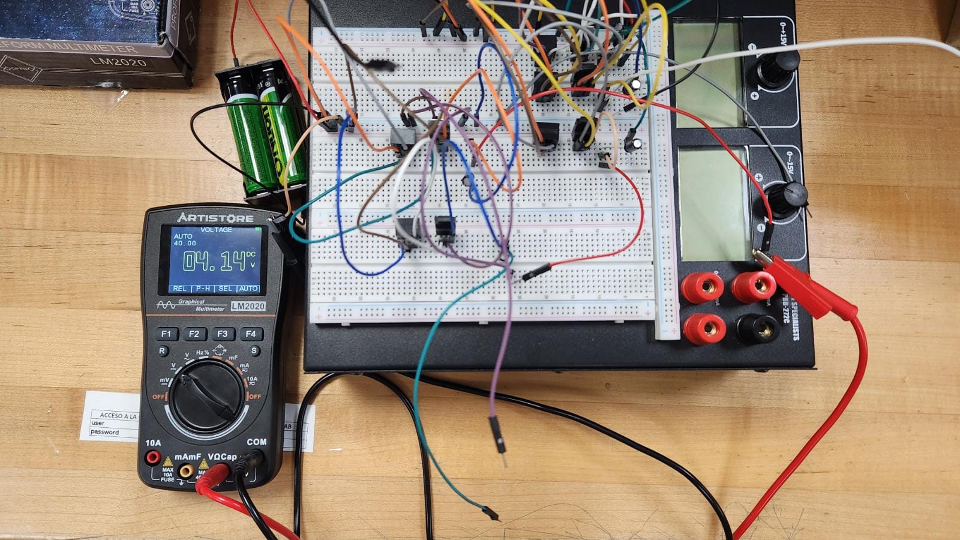
Final Project Report/Modular Design/Sub-Unit-PSU/Figures/sub-unit-4V.jpeg
