fabiomatos999/ICOM-4217-Project/Final Project Report/Modular Design/Sub-Unit/Figures/sub-unit-main-function.png

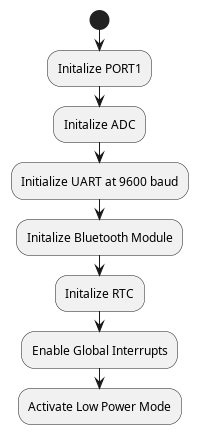
Final Project Report/Modular Design/Sub-Unit/Figures/sub-unit-main-function.png
