fabiomatos999/ICOM-4217-Project/Final Project Report/Modular Design/Sub-Unit/Figures/sub-unit-pic.jpeg

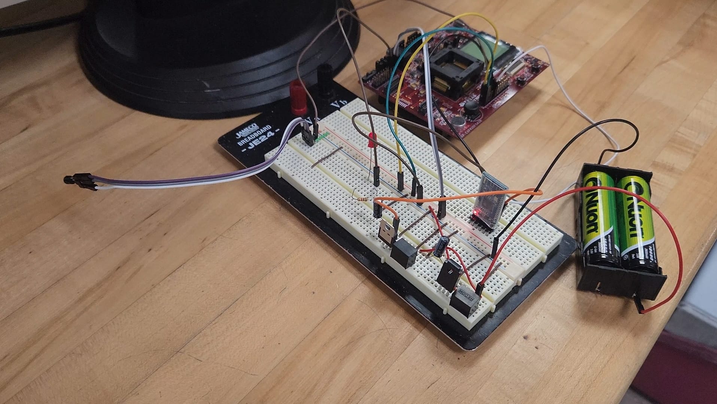
Final Project Report/Modular Design/Sub-Unit/Figures/sub-unit-pic.jpeg
