fabiomatos999/ICOM-4217-Project/Final Project Report/System Integration/Figures/log-file-picture.jpeg

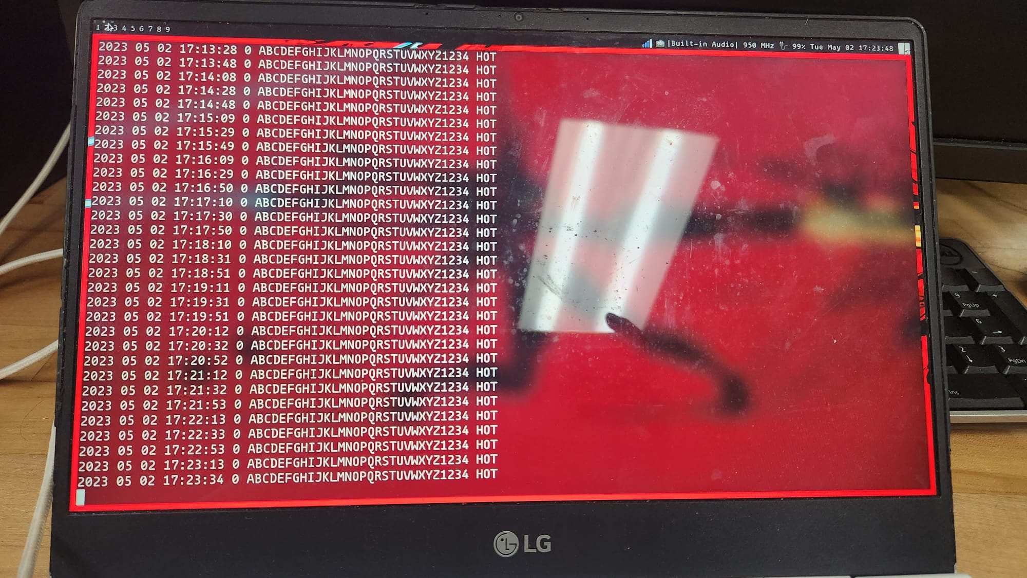
Final Project Report/System Integration/Figures/log-file-picture.jpeg
