fabiomatos999/ICOM-4217-Project/Hardware Design and System Updates/BDv3/Figures/bdv3-sub.png

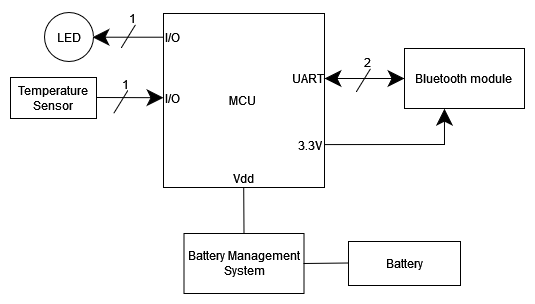
Hardware Design and System Updates/BDv3/Figures/bdv3-sub.png
