fabiomatos999/ICOM-4217-Project/Hardware Design and System Updates/Software-Plan/main-unit-bluetooth-isr.png

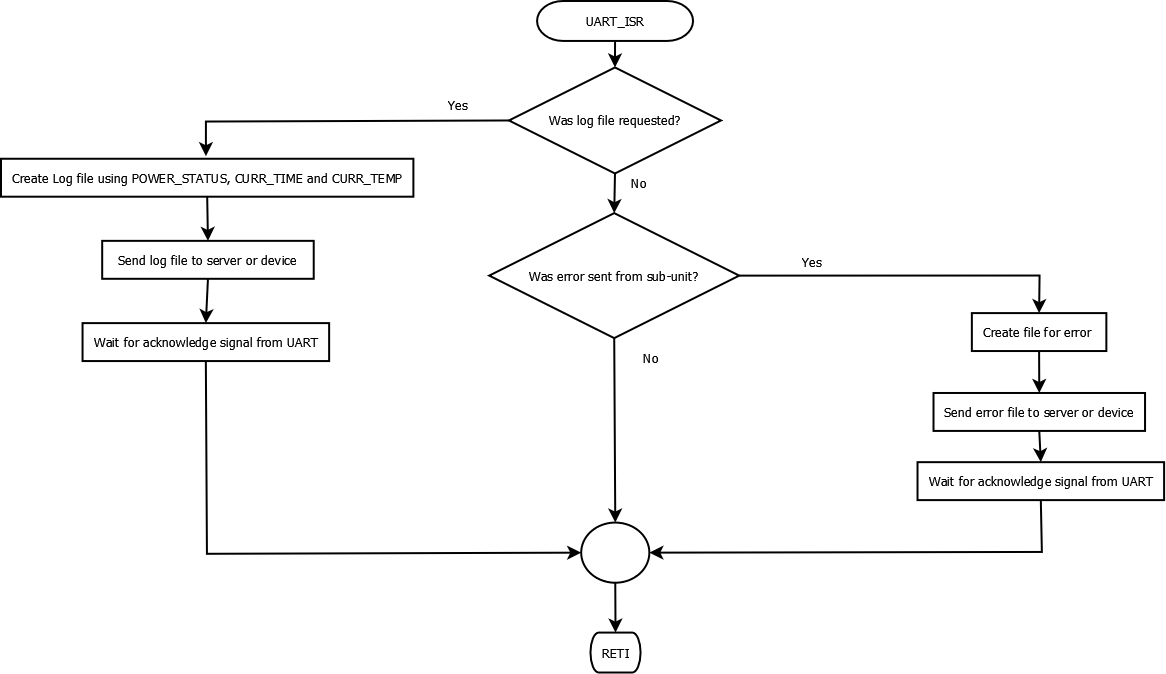
Hardware Design and System Updates/Software-Plan/main-unit-bluetooth-isr.png
