fabiomatos999/ICOM-4217-Project/Hardware Design and System Updates/Software-Plan/software-plan-sub-unit-main.png

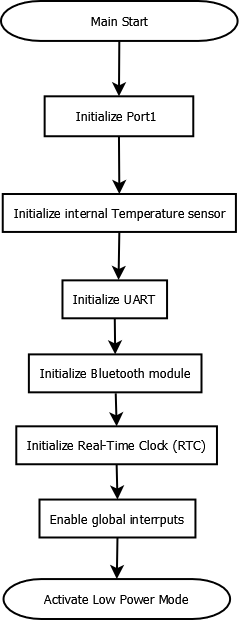
Hardware Design and System Updates/Software-Plan/software-plan-sub-unit-main.png
