fabiomatos999/ICOM-4217-Project/Hardware Design and System Updates/Software-Plan/software-plan-sub-unit-rtc-isr.png

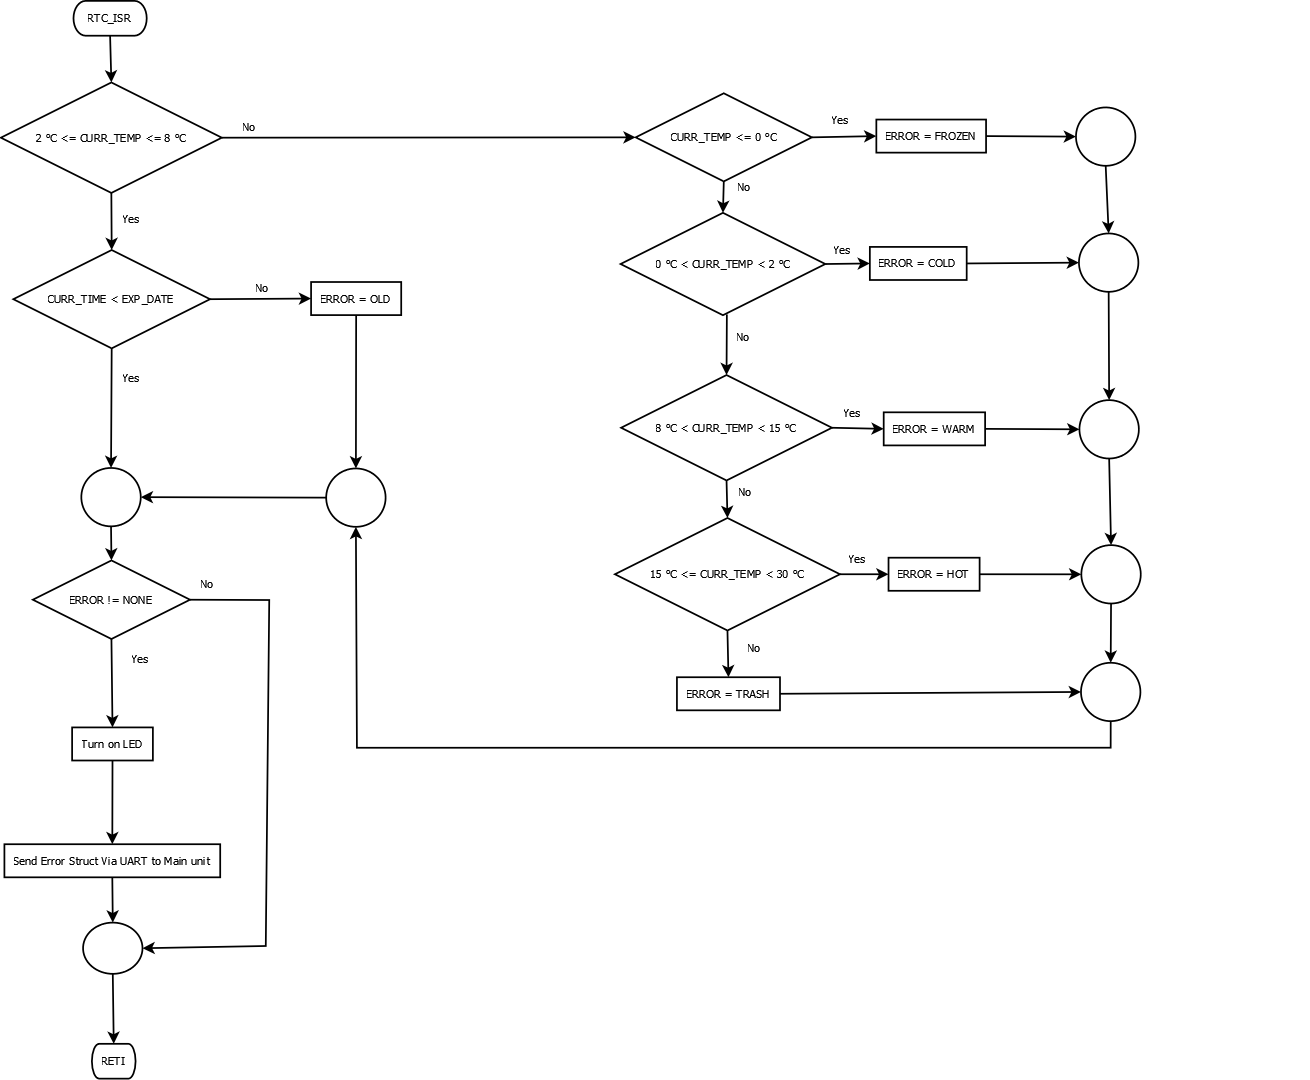
Hardware Design and System Updates/Software-Plan/software-plan-sub-unit-rtc-isr.png
