fabiomatos999/ICOM-4217-Project/Microprocessor Selection and BDV2/Figures/SW functionality B0.5.jpg

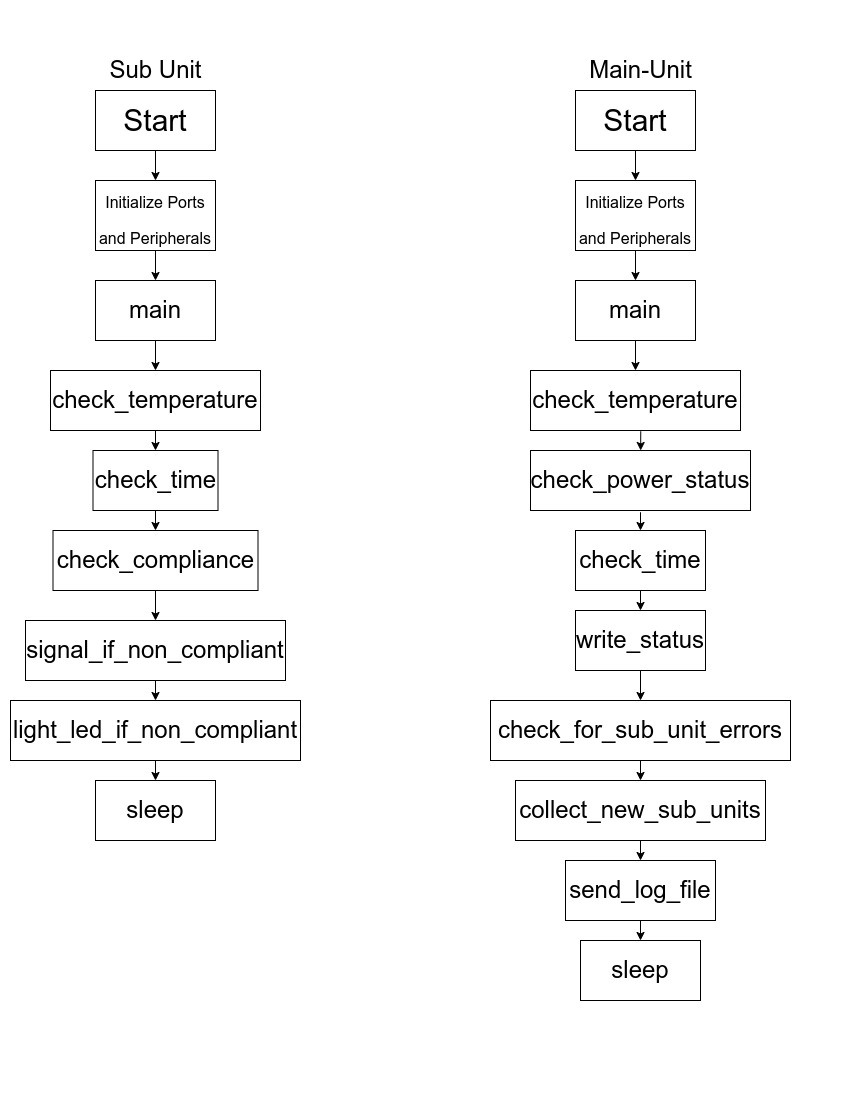
Microprocessor Selection and BDV2/Figures/SW functionality B0.5.jpg
