fabiomatos999/ICOM-4217-Project/Microprocessor Selection and BDV2/Figures/system-architecture-block-diagram.jpg

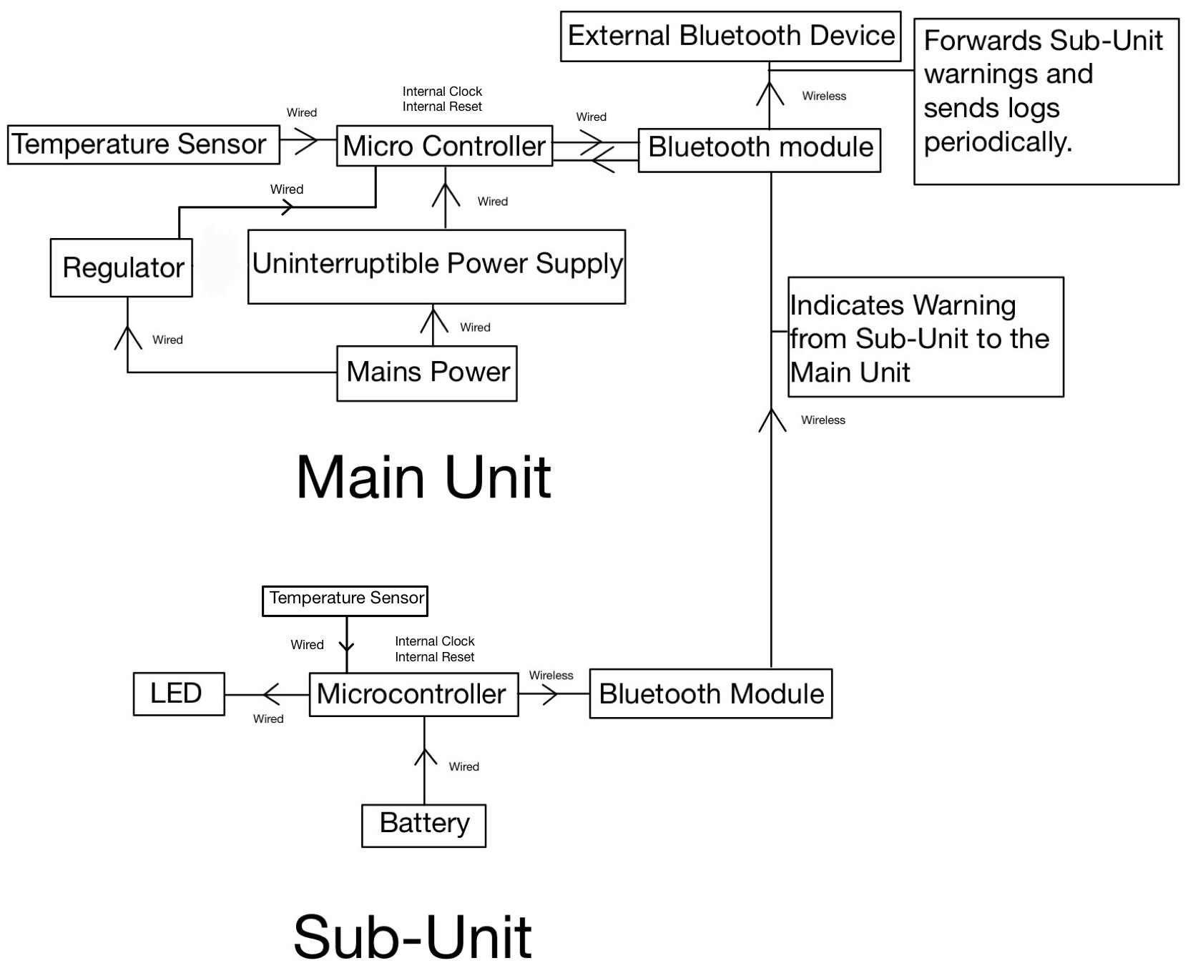
Microprocessor Selection and BDV2/Figures/system-architecture-block-diagram.jpg
