fabiomatos999/ICOM-4217-Project/Proposal/System-Conception/Figures/system-conception.jpg

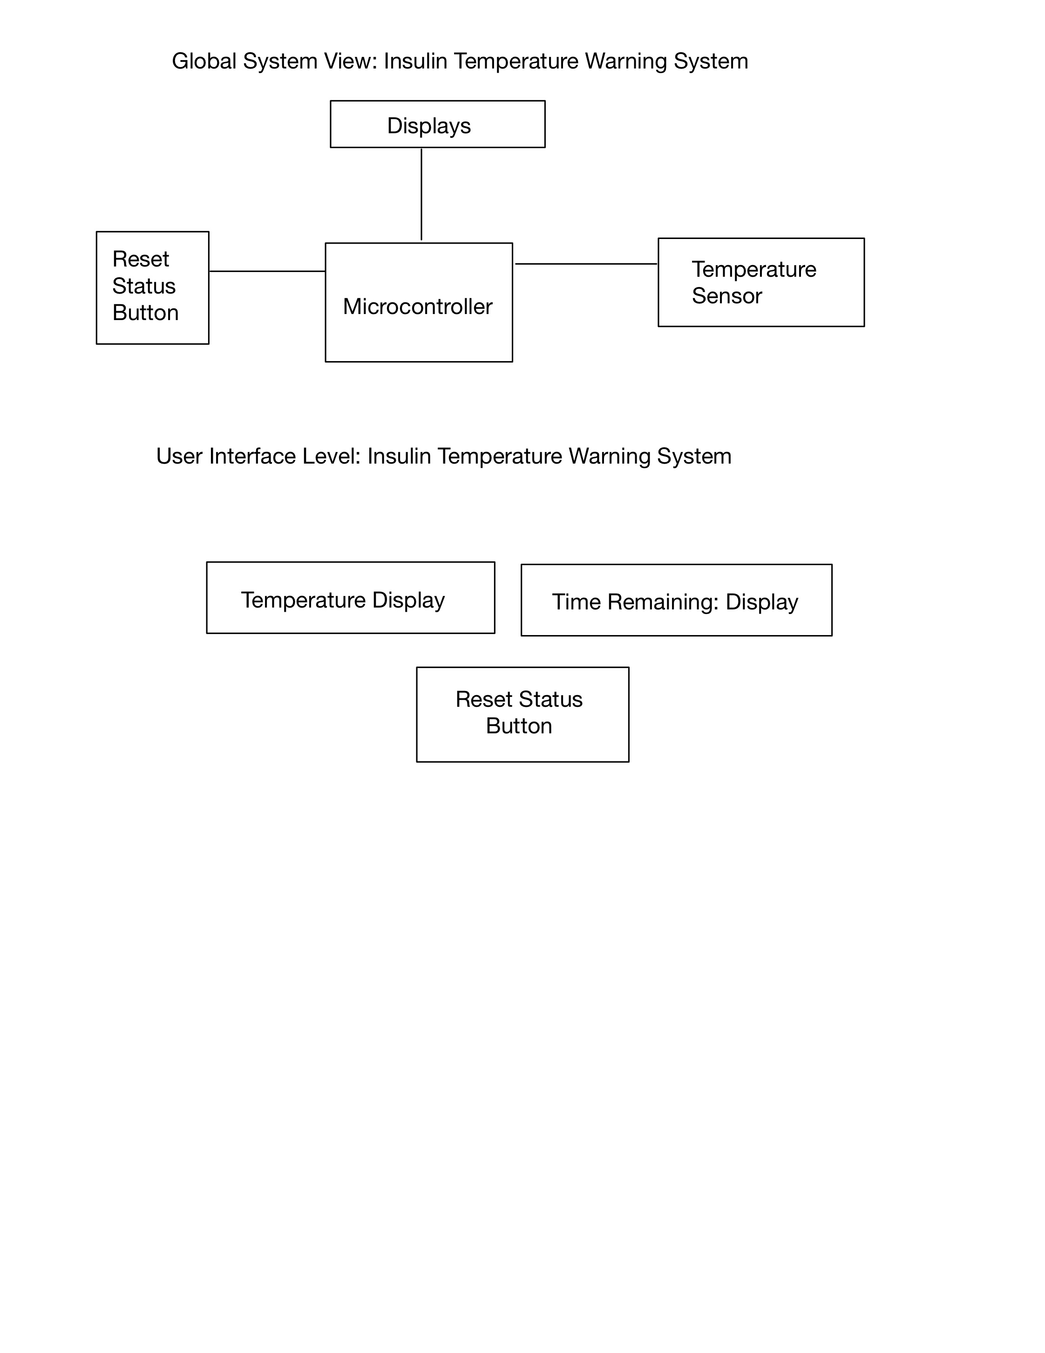
Proposal/System-Conception/Figures/system-conception.jpg
