fabiomatos999/ICOM-4217-Project/PROTOTYPE INTEGRATION and System Updates/Individual-BD-SCH-Pictures/Figures/main-unit-pic-3.jpeg

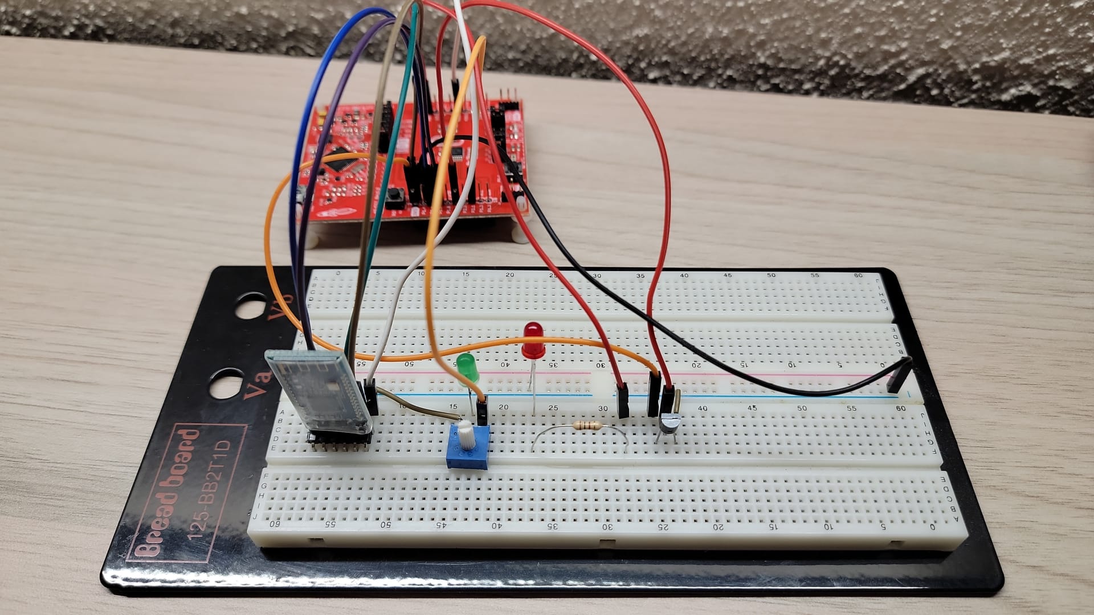
PROTOTYPE INTEGRATION and System Updates/Individual-BD-SCH-Pictures/Figures/main-unit-pic-3.jpeg
