fabiomatos999/ICOM-4217-Project/PROTOTYPE INTEGRATION and System Updates/Individual-BD-SCH-Pictures/Figures/sub-unit-pic.jpeg

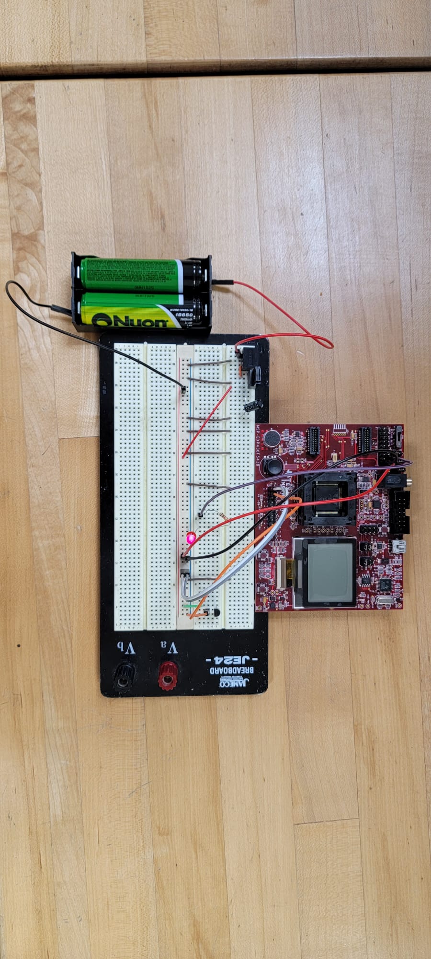
PROTOTYPE INTEGRATION and System Updates/Individual-BD-SCH-Pictures/Figures/sub-unit-pic.jpeg
