fabiomatos999/ICOM-4217-Project/PROTOTYPE INTEGRATION and System Updates/System-Schematic-Diagrams/Figures/sub-unit-psu.png

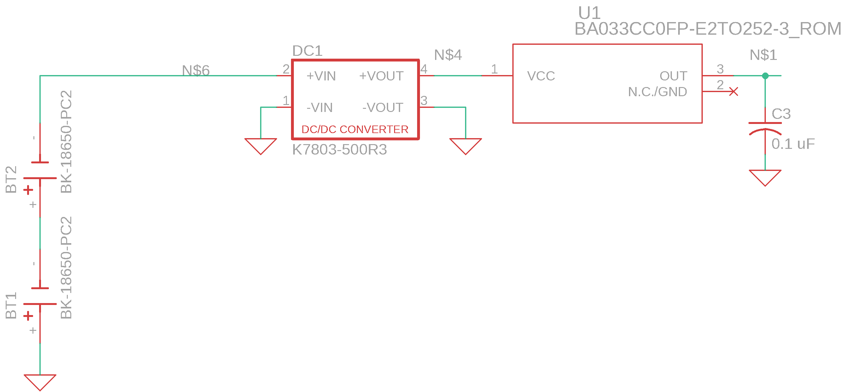
PROTOTYPE INTEGRATION and System Updates/System-Schematic-Diagrams/Figures/sub-unit-psu.png
