fabiomatos999/ICOM-4217-Project/Hardware Design and System Updates/BOM/bom.tex

\begin{landscape}
\section{Bill of Materials}
\begin{center}
  \begin{table}[h]
    \addtocounter{table}{-1}
  \begin{longtable}[c]{|c|c|c|c|c|c|c|c|c|}
    \hline
    \multicolumn{9}{|c|}{Bill of Materials: Main Unit}\\
    \hline
    Item\#&Qty&Description&Ref&Part\#&Unit Price&Est. Cost&Supplier&Datasheet\\
    \hline
    1&1&120-24 \si{\V} Transformer&TR1&TCT50-01E07AB&\$10.02&\$10.02&\href{https://www.digikey.com/en/products/detail/triad-magnetics/TCT50-01E07AB/2688350}{Digi-Key}&\href{http://catalog.triadmagnetics.com/Asset/TCT50-01E07AB.pdf}{Data-sheet}\\
    \hline
    2&1&Diode Rectifier&B1&KMB23S&\$0.47&\$0.47&\href{https://www.digikey.com/en/products/detail/smc-diode-solutions/KMB23S/7898339}{Digi-Key}&\href{https://www.smc-diodes.com/propdf/KMB22S\%20THRU\%20KMB220S\%20N1952\%20REV.B.pdf}{Data-sheet}\\
    \hline
    3&1&22.8\si{\V} Zener Diode&D2&NZX22C,133&\$0.20&\$0.20&\href{https://www.digikey.com/en/products/detail/nexperia-usa-inc/NZX22C-133/2296288}{Digi-Key}&\href{https://assets.nexperia.com/documents/data-sheet/NZX_SER.pdf}{Data-sheet}\\
    \hline
    4&1&470\si{\micro\farad} 25\si{\V} Capacitor&C1&25ZLH470MEFC10X12.5&\$0.57&\$0.57&\href{https://www.digikey.com/en/products/detail/rubycon/25ZLH470MEFC10X12-5/3563614}{Digi-Key}&\href{https://www.rubycon.co.jp/wp-content/uploads/catalog-aluminum/ZLH.pdf}{Data-sheet}\\
    \hline
    5&1&9\si{\V} DC-DC Converter&DC3&R-78W9.0-0.5&\$10.37&\$10.37&\href{https://www.digikey.com/en/products/detail/recom-power/R-78W9-0-0-5/4930587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}{Digi-Key}&\href{https://recom-power.com/pdf/Innoline/R-78W-0.5.pdf}{Data-sheet}\\
    \hline
    6&2&Regular Diode&D1,D3&1N4004-G&\$0.21&\$0.42&\href{https://www.digikey.com/en/products/detail/comchip-technology/1N4004-G/1979655}{Digi-Key}&\href{https://www.comchiptech.com/admin/files/product/1N4001-G\%20Thru.\%201N4007-G\%20RevB.pdf}{Data-sheet}\\
    \hline
    7&2&3.6\si{\V} Battery&BT1,BT2&NURE18650-1&\$13.99&\$27.98&\href{https://www.batteriesplus.com/productdetails/nure18650=1}{BatteryPlus}&\href{https://www.batteriesplus.com/productdetails/nure18650=1}{Data-sheet}\\
    \hline
    8&2&3.3\si{\V} DC-DC Converter&DC1,DC2&K7803-500R3&\$3.25&\$6.50&\href{https://www.digikey.com/en/products/detail/recom-power/R-78E3-3-0-5/3593412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}{Digi-Key}&\href{https://recom-power.com/pdf/Innoline/R-78E-0.5.pdf}{Data-sheet}\\
    \hline
    9&2&3.3\si{\V} LDO&U1-U2&BA33BC0T&\$2.62&\$5.24&\href{https://www.digikey.com/en/products/detail/rohm-semiconductor/BA33BC0T/722279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}{Digi-Key}&\href{https://www.rohm.com/datasheet?p=BA33BC0T&dist=Digi-key&media=referral&source=digi-key.com&campaign=Digi-key}{Data-sheet}\\
    \hline
    10&2&0.1\si{\micro\farad} 50\si{\V} Capacitor&C1,C2&UVR1H0R1MDD1TD&\$0.28&\$0.56&\href{https://www.digikey.com/en/products/detail/nichicon/UVR1H0R1MDD1TD/4328983}{Digi-Key}&\href{https://download.datasheets.com/pdfs/2016/10/6/6/6/44/578/nch_/manual/93896153625063e-uvr.pdf}{Data-sheet}\\
	\hline
    11&1&16 MHz MCU&U3&MSP430FR2110IPW16&\$1.21&\$1.21&\href{https://www.digikey.com/en/products/detail/texas-instruments/MSP430FR2110IPW16R/6570204}{Digi-key}&\href{https://www.ti.com/lit/ds/symlink/msp430fr2111.pdf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\%253A\%252F\%252Fgoogle.com}{Data-sheet}\\
     \hline
	12&1&Bluetooth Module& HM-10& HM-10& \$5.30&\$5.30&\href{https://www.amazon.com/HiLetgo-Bluetooth-Wireless-Compatible-Arduino/dp/B00WGPKZ8Y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\%2Caps\%2C133&sr=8-3}{Amazon}&\href{https://people.ece.cornell.edu/land/courses/ece4760/PIC32/uart/HM10/DSD\%20TECH\%20HM-10\%20datasheet.pdf}{Data-sheet}\\
	\hline
    13&1&18650 Battery Holder&BT1,BT2&BK-18650-PC4&\$6.22&\$6.22&\href{https://www.digikey.com/en/products/detail/mpd-memory-protection-devices/BK-18650-PC4/2330513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}{Digi-Key}&\href{https://www.memoryprotectiondevices.com/datasheets/BK-18650-PC4-datasheet.pdf}{Data-sheet}\\
	\hline
    14&1&Op Amp&U4&TLR342F-GE2&\$0.70&\$0.70&\href{https://www.digikey.com/en/products/detail/rohm-semiconductor/TLR342F-GE2/7896247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}{Digi-Key}&\href{https://www.rohm.com/datasheet?p=TLR342F&dist=Digi-key&media=referral&source=digi-key.com&campaign=Digi-key}{Data-sheet}\\
	\hline
    15&1&39\si{\ohm} Resistor&R5&CF18JT39R0&\$0.10&\$0.10&\href{https://www.digikey.com/en/products/detail/stackpole-electronics-inc/CF18JT39R0/1741693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\%2BQA}{Digi-Key}&\href{https://www.seielect.com/Catalog/SEI-CF_CFM.pdf}{Data-sheet}\\
	\hline
    16&1&5.1\si{\ohm} Resistor&R6&CFM14JT5R10&\$0.10&\$0.10&\href{https://www.digikey.com/en/products/detail/stackpole-electronics-inc/CFM14JT5R10/1742230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\%2BQA}{Digi-Key}&\href{https://www.seielect.com/Catalog/SEI-CF_CFM.pdf}{Data-sheet}\\
	\hline
    17&1&1\si{\kilo\ohm} Resistor&R7&CF14JT1K00&\$0.10&\$0.10&\href{https://www.digikey.com/en/products/detail/stackpole-electronics-inc/CF14JT1K00/1741314}{Digi-Key}&\href{https://www.seielect.com/Catalog/SEI-CF_CFM.pdf}{Data-sheet}\\
	\hline
    18&1&620\si{\ohm} Resistor&R4&CF18JT620R&\$0.10&\$0.10&\href{https://www.digikey.com/en/products/detail/stackpole-electronics-inc/CF18JT620R/1741752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}{Digi-Key}&\href{https://www.seielect.com/Catalog/SEI-CF_CFM.pdf}{Data-sheet}\\
	\hline
    19&1&5\si{\V} DC-DC Converter&DC4&TSR 1-2450&\$5.80&\$5.80&\href{https://www.digikey.com/en/products/detail/traco-power/TSR-1-2450/9383780}{Digi-Key}&\href{https://www.tracopower.com/sites/default/files/products/datasheets/tsr1_datasheet.pdf}{Data-sheet}\\
	\hline
    20&1&5\si{\V} LDO&U6&L7805CV&\$0.69&\$0.69&\href{https://www.digikey.com/en/products/detail/stmicroelectronics/L7805CV/585964}{Digi-Key}&\href{https://www.st.com/content/ccc/resource/technical/document/datasheet/41/4f/b3/b0/12/d4/47/88/CD00000444.pdf/files/CD00000444.pdf/jcr:content/translations/en.CD000004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}{Data-sheet}\\
	\hline
    21&1&Temperature Sensor&U5&TMP36GT9Z&\$2.40&\$2.40&\href{https://www.digikey.com/en/products/detail/analog-devices-inc/TMP36GT9Z/820404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}{Digi-Key}&\href{https://www.analog.com/media/en/technical-documentation/data-sheets/TMP35_36_37.pdf}{Data-sheet}\\
	\hline
    22&1&18650 Battery Charger&&Snado&\$12.69&\$12.69&\href{https://www.amazon.com/dp/B0721JP6FK?psc=1&ref=ppx_yo2ov_dt_b_product_details}{Amazon}&\href{https://www.amazon.com/dp/B0721JP6FK?psc=1&ref=ppx_yo2ov_dt_b_product_details}{Data-sheet}\\
	\hline
    23&2&330\si{\ohm} Resistor&R1,R2&CF18JT330R&\$0.10&\$0.20&\href{https://www.seielect.com/Catalog/SEI-CF_CFM.pdf}{Digi-Key}&\href{https://www.seielect.com/Catalog/SEI-CF_CFM.pdf}{Data-sheet}\\
	\hline
    24&1&100\si{\ohm} Resistor&R3&CF14JT100R&\$0.10&\$0.10&\href{https://www.digikey.com/en/products/detail/stackpole-electronics-inc/CF14JT100R/1741261}{Digi-Key}&\href{https://www.seielect.com/Catalog/SEI-CF_CFM.pdf}{Data-sheet}\\
	\hline
    25&1&Red LED&LED1&XLUR12D&\$0.29&\$0.29&\href{https://www.digikey.com/en/products/detail/sunled/XLUR12D/4745846}{Digi-Key}&\href{https://octopart.com/datasheet/lhg3392-jameco+valuepro-2312745}{Data-sheet}\\
	\hline
    26&1&Green LED&LED2&WP7113GD&\$0.33&\$0.33&\href{https://www.digikey.com/en/products/detail/kingbright/WP7113GD/1747662}{Digi-Key}&\href{https://octopart.com/datasheet/lhg3392-jameco+valuepro-2312745}{Data-sheet}\\
	\hline
    \multicolumn{5}{|c|}{}&Total&\$98.66&\multicolumn{2}{c|}{}\\
    \hline
  \end{longtable}
  \caption{Bill of Materials: Main Unit}
  \label{BOM:Main-Unit}
  \end{table}
  \begin{table}[h]
    \addtocounter{table}{-1}
  \begin{longtable}[c]{|c|c|c|c|c|c|c|c|c|}
    \hline
    \multicolumn{9}{|c|}{Bill of Materials: Sub Unit}\\
    \hline
    Item\#&Qty&Description&Ref&Part\#&Unit Price&Est. Cost&Supplier&Datasheet\\
    \hline
    1&2&3.6\si{\V} Battery&BT1,BT2&NURE18650-1&\$13.99&\$27.98&\href{https://www.batteriesplus.com/productdetails/nure18650=1}{BatteryPlus}&\href{https://www.batteriesplus.com/productdetails/nure18650=1}{Data-sheet}\\
    \hline
    2&1&3.3\si{\V} DC-DC Converter&DC1&K7803-500R3&\$2.26&\$2.26&\href{https://www.digikey.com/en/products/detail/mornsun-america-llc/K7803-500R3/13168320}{Digi-Key}&\href{https://www.mornsun-power.com/html/pdf/K7803-500R3.html}{Data-sheet}\\
    \hline
    3&1&3.3\si{\V} LDO&U1&BA033CC0FP-E2&\$1.41&\$1.41&\href{https://www.digikey.com/en/products/detail/rohm-semiconductor/BA033CC0FP-E2/722186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}{Digi-Key}&\href{https://www.rohm.com/datasheet?p=BA033CC0FP&dist=Digi-key&media=referral&source=digi-key.com&campaign=Digi-key}{Data-sheet}\\
    \hline
    4&1&0.1\si{\micro\farad} 50\si{\V} Capacitor&C1,C2&UVR1H0R1MDD1TD&\$0.28&\$0.28&\href{https://www.digikey.com/en/products/detail/nichicon/UVR1H0R1MDD1TD/4328983}{Digi-Key}&\href{https://download.datasheets.com/pdfs/2016/10/6/6/6/44/578/nch_/manual/93896153625063e-uvr.pdf}{Data-sheet}\\
    \hline
    5&1&16\si{\MHz} MCU&U2&MSP430FR2000IPW16&\$1.31&\$1.31&\href{https://www.digikey.com/en/products/detail/texas-instruments/MSP430FR2000IPW16/7650247}{Digi-Key}&\href{https://www.ti.com/general/docs/suppproductinfo.tsp?distId=10&gotoUrl=https\%3A\%2F\%2Fwww.ti.com\%2Flit\%2Fgpn\%2Fmsp430fr2000}{Data-Sheet}\\
    \hline
    6&1&68\si{\ohm} Resistor&R1&CF18JT68R0&\$0.10&\$0.10&\href{https://www.digikey.com/en/products/detail/stackpole-electronics-inc/CF18JT68R0/1741755}{Digi-Key}&\href{https://www.seielect.com/Catalog/SEI-CF_CFM.pdf}{Data-sheet}\\
    \hline
    7&1&Red LED&LED1&SSL-LX3052ID&\$0.46&\$0.46&\href{https://www.digikey.com/en/products/detail/lumex-opto-components-inc/SSL-LX3052ID/39603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}{Digi-Key}&\href{https://www.lumex.com/spec/SSL-LX3052ID.pdf}{Data-sheet}\\
	\hline
    8&1&5\si{\V} DC-DC Converter&&TSR 1-2450&\$5.80&\$5.80&\href{https://www.digikey.com/en/products/detail/traco-power/TSR-1-2450/9383780}{Digi-Key}&\href{https://www.tracopower.com/sites/default/files/products/datasheets/tsr1_datasheet.pdf}{Data-sheet}\\
	\hline
    9&1&5\si{\V} LDO&&L7805CV&\$0.69&\$0.69&\href{https://www.digikey.com/en/products/detail/stmicroelectronics/L7805CV/585964}{Digi-Key}&\href{https://www.st.com/content/ccc/resource/technical/document/datasheet/41/4f/b3/b0/12/d4/47/88/CD00000444.pdf/files/CD00000444.pdf/jcr:content/translations/en.CD000004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}{Data-sheet}\\
    \hline
	10&1&Bluetooth Module& HM-10& HM-10& \$5.30&\$5.30&\href{https://www.amazon.com/HiLetgo-Bluetooth-Wireless-Compatible-Arduino/dp/B00WGPKZ8Y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\%2Caps\%2C133&sr=8-3}{Amazon}&\href{https://people.ece.cornell.edu/land/courses/ece4760/PIC32/uart/HM10/DSD\%20TECH\%20HM-10\%20datasheet.pdf}{Data-sheet}\\
    \hline
    11&1&18650 Battery Holder&BT1,BT2&BK-18650-PC4&\$6.22&\$6.22&\href{https://www.digikey.com/en/products/detail/mpd-memory-protection-devices/BK-18650-PC4/2330513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}{Digi-Key}&\href{https://www.memoryprotectiondevices.com/datasheets/BK-18650-PC4-datasheet.pdf}{Data-sheet}\\
    \hline
    12&1&Op Amp&U3&TLR342F-GE2&\$0.70&\$0.70&\href{https://www.digikey.com/en/products/detail/rohm-semiconductor/TLR342F-GE2/7896247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}{Digi-Key}&\href{https://www.rohm.com/datasheet?p=TLR342F&dist=Digi-key&media=referral&source=digi-key.com&campaign=Digi-key}{Data-sheet}\\
	\hline
    13&1&39\si{\ohm} Resistor&R6&CF18JT39R0&\$0.10&\$0.10&\href{https://www.digikey.com/en/products/detail/stackpole-electronics-inc/CF18JT39R0/1741693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\%2BQA}{Digi-Key}&\href{https://www.seielect.com/Catalog/SEI-CF_CFM.pdf}{Data-sheet}\\
	\hline
    14&1&5.1\si{\ohm} Resistor&R7&CFM14JT5R10&\$0.10&\$0.10&\href{https://www.digikey.com/en/products/detail/stackpole-electronics-inc/CFM14JT5R10/1742230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\%2BQA}{Digi-Key}&\href{https://www.seielect.com/Catalog/SEI-CF_CFM.pdf}{Data-sheet}\\
	\hline
    15&1&1\si{\kilo\ohm} Resistor&R8&CF14JT1K00&\$0.10&\$0.10&\href{https://www.digikey.com/en/products/detail/stackpole-electronics-inc/CF14JT1K00/1741314}{Digi-Key}&\href{https://www.seielect.com/Catalog/SEI-CF_CFM.pdf}{Data-sheet}\\
	\hline
    16&1&620\si{\ohm} Resistor&R5&CF18JT620R&\$0.10&\$0.10&\href{https://www.digikey.com/en/products/detail/stackpole-electronics-inc/CF18JT620R/1741752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}{Digi-Key}&\href{https://www.seielect.com/Catalog/SEI-CF_CFM.pdf}{Data-sheet}\\
	\hline
    17&1&Temperature Sensor&U4&TMP36GT9Z&\$2.40&\$2.40&\href{https://www.digikey.com/en/products/detail/analog-devices-inc/TMP36GT9Z/820404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}{Digi-Key}&\href{https://www.analog.com/media/en/technical-documentation/data-sheets/TMP35_36_37.pdf}{Data-sheet}\\
	\hline
    18&1&18650 Battery Charger&&Snado&\$12.69&\$12.69&\href{https://www.amazon.com/dp/B0721JP6FK?psc=1&ref=ppx_yo2ov_dt_b_product_details}{Amazon}&\href{https://www.amazon.com/dp/B0721JP6FK?psc=1&ref=ppx_yo2ov_dt_b_product_details}{Data-sheet}\\
	\hline
    19&1&5\si{\V} DC-DC Converter&DC2&TSR 1-2450&\$5.80&\$5.80&\href{https://www.digikey.com/en/products/detail/traco-power/TSR-1-2450/9383780}{Digi-Key}&\href{https://www.tracopower.com/sites/default/files/products/datasheets/tsr1_datasheet.pdf}{Data-sheet}\\
	\hline
    20&1&5\si{\V} LDO&U5&L7805CV&\$0.69&\$0.69&\href{https://www.digikey.com/en/products/detail/stmicroelectronics/L7805CV/585964}{Digi-Key}&\href{https://www.st.com/content/ccc/resource/technical/document/datasheet/41/4f/b3/b0/12/d4/47/88/CD00000444.pdf/files/CD00000444.pdf/jcr:content/translations/en.CD000004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}{Data-sheet}\\
	\hline
    \multicolumn{5}{|c|}{}&Total&\$74.49&\multicolumn{2}{c|}{}\\
    \hline
  \end{longtable}
  \caption{Bill of Materials: Sub Unit}
  \label{BOM:Sub-Unit}
  \end{table}
\end{center}
\end{landscape}
