fabiomatos999/ICOM-4217-Project/PROTOTYPE INTEGRATION and System Updates/System-Schematic-Diagrams/Power-Supply/Sub Unit PSU/sub-unit-psu-order.txt

1	3.3V	LM3281YFQR								
1	LDO     BA033CC0FP-E2
1	B2	ICR18650-2200-F
