fabiomatos999/ICOM-4217-Project/PROTOTYPE INTEGRATION and System Updates/System-Schematic-Diagrams/Power-Supply/Main Unit PSU/main-unit-psu-order2.txt

Order list for C:/Users/gram/Documents/ICOM-4217-Project/Hardware Design and System Updates/Power-Supply/Main Unit PSU/main-unit-psu.sch
Exported from EAGLE with DesignLink

Quantity	Value	Package	Order code	Manufacturer	Manuf. Code	Availability	Price (from)	Description
1		B-DIL	unknown					
1	10 uF	C050-024X044	87AC8155	KEMET	ESW106M025AC3AA	19585	0.061	KEMET - ESW106M025AC3AA - Electrolytic Capacitor, 10 µF, 25 V, ± 20%, PC Pin, 3000 hours @ 105°C, Polar
3	1N4004	DO41-10	84K8827	ONSEMI	1N4004RLG	55122	0.052	ONSEMI - 1N4004RLG - Standard Recovery Diode, 400 V, 1 A, Single, 1.1 V, 150 ns, 30 A
2	3.3V	NME	29X1501	MURATA POWER SOLUTIONS	CME0303S3C	0	2.74	MURATA POWER SOLUTIONS - CME0303S3C - Isolated Through Hole DC/DC Converter, ITE, 1:1, 750 mW, 1 Output, 3.3 V, 227 mA
1	CRAA	CRAA	unknown					
2	MCP1703CB	SOT23	unknown					
1		EE20-1	98M4353	TRIAD MAGNETICS	TCT3-11E07AE	0	7.08	TRIAD MAGNETICS - TCT3-11E07AE - Chassis Mount Transformer, Class II, Class 2 Energy Limiting, 120V, 10V, 2.5 VA, 50Hz / 60Hz
