fabiomatos999/ICOM-4217-Project/Final Project Report/Appendix/Figures/Sub-Unit/SSL-LX3052ID.pdf

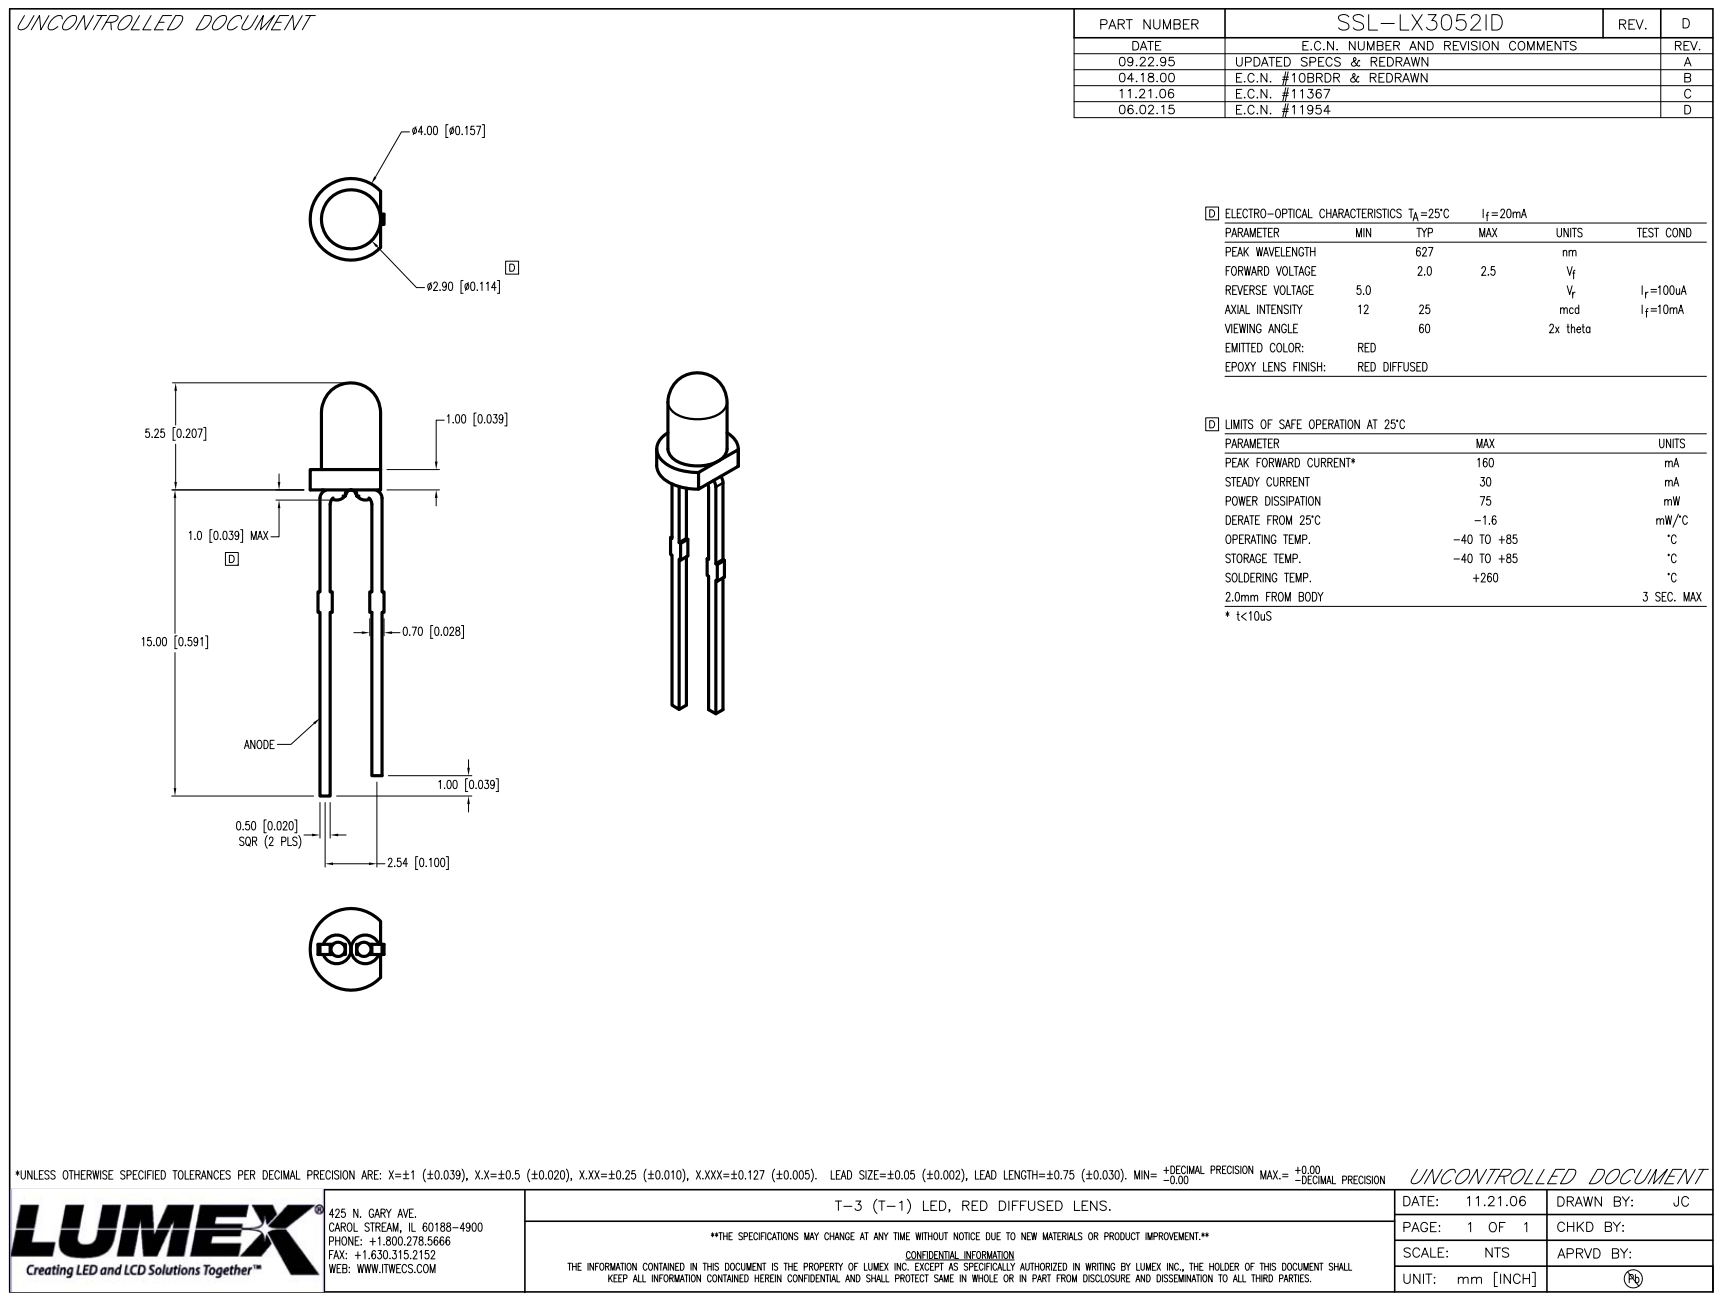
[picture p65: page 1]
