fabiomatos999/ICOM-4217-Project/PROTOTYPE INTEGRATION and System Updates/System-Schematic-Diagrams/Main-Unit-and-PSU/main-unit-psu.sch

## EAGLE design PROTOTYPE INTEGRATION and System Updates/System-Schematic-Diagrams/Main-Unit-and-PSU/main-unit-psu.sch (2023-04-27)

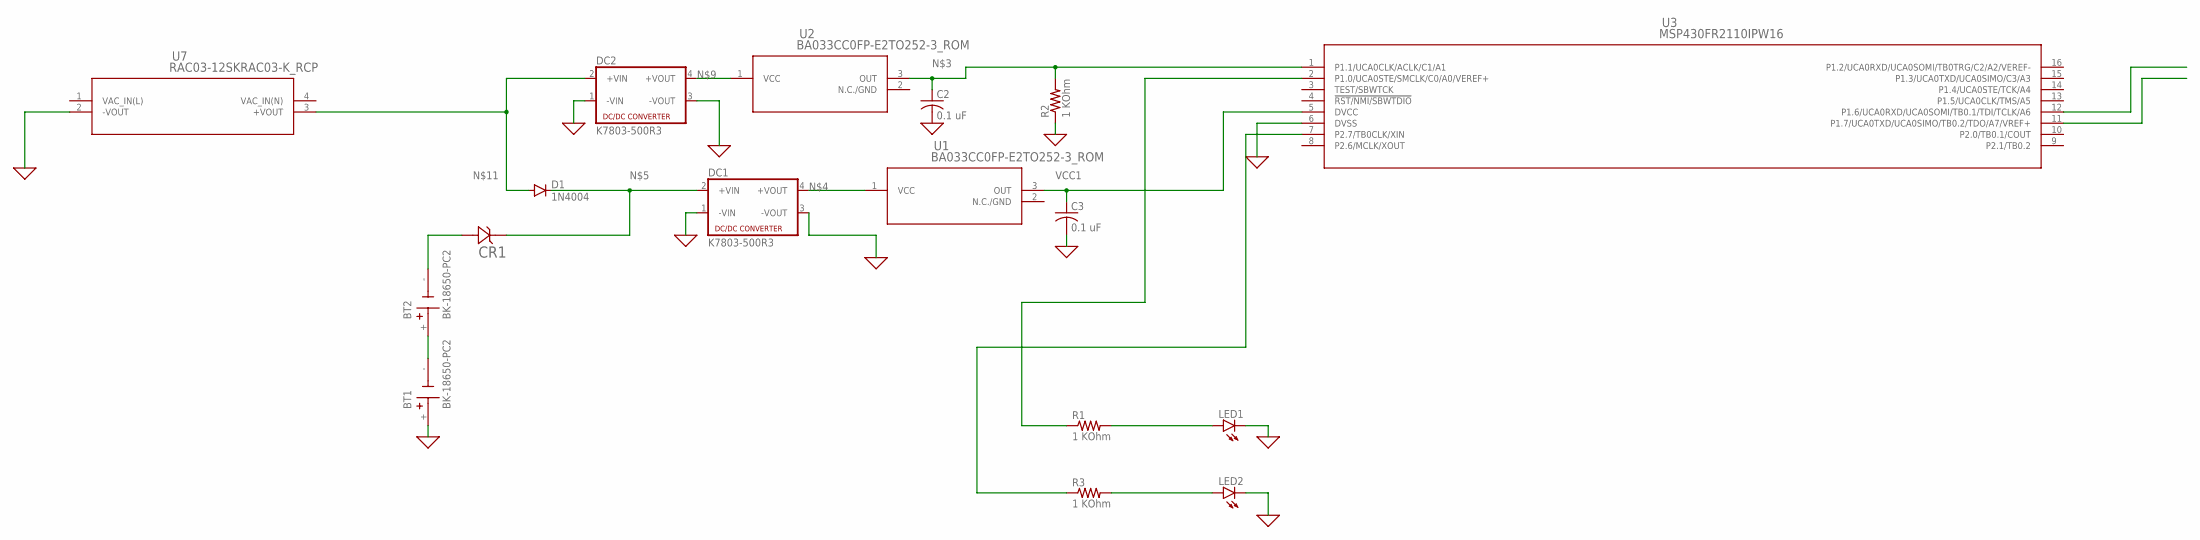
[picture p66: schematic main-unit-psu.sch]

Parts:
BT1, BT2: BK-18650-PC2; BAT_BK-18650-PC2
C2, C3: 0.1 uF; C050-024X044
CR1: 1N5819DO-41_STM; DO-41_STM
D1: 1N4004; DO41-10
DC1, DC2: K7803-500R3; NME
LED1, LED2: LED5MM
R1, R3: 1 KOhm; 0204/7
R2: 1 KOhm; 0207/2V
U1, U2: BA033CC0FP-E2TO252-3_ROM; TO252-3_ROM
U3: MSP430FR2110IPW16; PW16_TEX
U7: RAC03-12SKRAC03-K_RCP; RAC03-K_RCP

Connections:
0: BT1.+, C2.2, C3.2, DC1.1 (-VIN), DC1.3 (-VOUT), DC2.1 (-VIN), DC2.3 (-VOUT), LED1.K (C), LED2.K (C), R2.1, U3.6 (DVSS), U7.2 (-VOUT)
unnamed: C2.1, R2.2, U2.3 (OUT), U3.1 (P1.1/UCA0CLK/ACLK/C1/A1)
unnamed: DC1.4 (+VOUT), U1.1 (VCC)
unnamed: CR1.1, D1.C, DC1.2 (+VIN)
unnamed: BT1.-, BT2.+
unnamed: BT2.-, CR1.2
unnamed: DC2.4 (+VOUT), U2.1 (VCC)
unnamed: D1.A, DC2.2 (+VIN), U7.3 (+VOUT)
unnamed: R3.1, U3.7 (P2.7/TB0CLK/XIN)
unnamed: LED1.A, R1.2
unnamed: LED2.A, R3.2
unnamed: R1.1, U3.2 (P1.0/UCA0STE/SMCLK/C0/A0/VEREF+)
VCC1: C3.1, U1.3 (OUT), U3.5 (DVCC)
