fabiomatos999/ICOM-4217-Project/PROTOTYPE INTEGRATION and System Updates/System-Schematic-Diagrams/Main-Unit/Main-Unit-Schematic.sch

## EAGLE design PROTOTYPE INTEGRATION and System Updates/System-Schematic-Diagrams/Main-Unit/Main-Unit-Schematic.sch (2023-04-27)

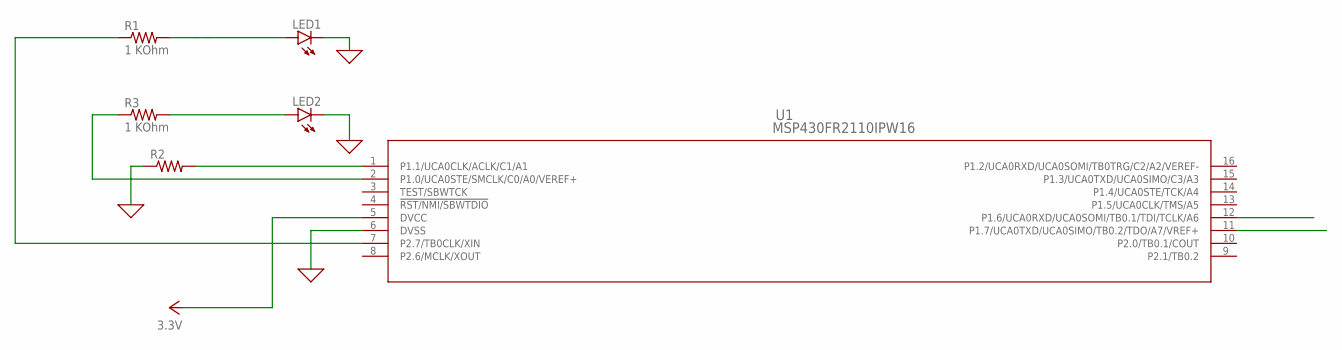
[picture p67: schematic Main-Unit-Schematic.sch]

Parts:
LED1, LED2: LED5MM
R1, R3: 1 KOhm; 0204/7
R2: R-US_0204/7; 0204/7
U1: MSP430FR2110IPW16; PW16_TEX

Connections:
0: LED1.K (C), LED2.K (C), R2.1, U1.6 (DVSS)
unnamed: R2.2, U1.1 (P1.1/UCA0CLK/ACLK/C1/A1)
unnamed: R1.1, U1.7 (P2.7/TB0CLK/XIN)
unnamed: R3.1, U1.2 (P1.0/UCA0STE/SMCLK/C0/A0/VEREF+)
unnamed: LED1.A, R1.2
unnamed: LED2.A, R3.2
VCC: U1.5 (DVCC)
