fabiomatos999/ICOM-4217-Project/PROTOTYPE INTEGRATION and System Updates/System-Schematic-Diagrams/Sub-Unit-and-PSU/sub-unit-and-psu.sch

## EAGLE design PROTOTYPE INTEGRATION and System Updates/System-Schematic-Diagrams/Sub-Unit-and-PSU/sub-unit-and-psu.sch (2023-04-27)

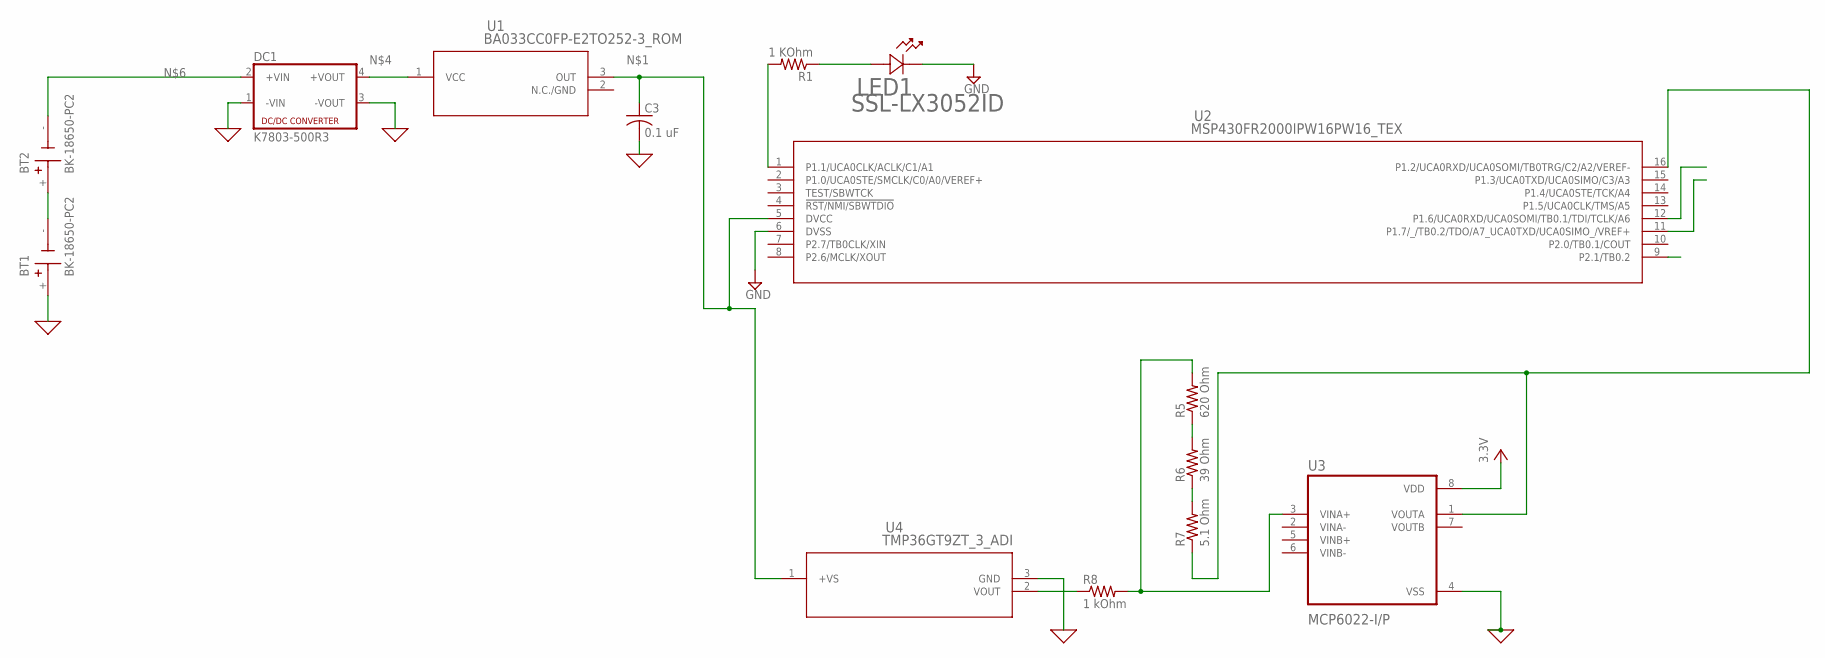
[picture p68: schematic sub-unit-and-psu.sch]

Parts:
BT1, BT2: BK-18650-PC2; BAT_BK-18650-PC2
C3: 0.1 uF; C050-024X044
DC1: K7803-500R3; NME
LED1: SSL-LX3052ID; LED_SSL-LX30_T-3_LUM
R1: 1 KOhm; 0204/5
R5: 620 Ohm; 0204/7
R6: 39 Ohm; 0204/7
R7: 5.1 Ohm; 0204/7
R8: 1 kOhm; 0204/7
U1: BA033CC0FP-E2TO252-3_ROM; TO252-3_ROM
U2: MSP430FR2000IPW16PW16_TEX; PW16_TEX
U3: MCP6022-I/P; DIP787W46P254L927H533Q8
U4: TMP36GT9ZT_3_ADI; T_3_ADI

Connections:
0: BT1.+, C3.2, DC1.1 (-VIN), DC1.3 (-VOUT), U3.4 (VSS), U4.3 (GND)
GND: LED1.1 (ANODE), U2.6 (DVSS)
unnamed: C3.1, U1.3 (OUT), U2.5 (DVCC), U4.1 (+VS)
unnamed: BT1.-, BT2.+
unnamed: LED1.2, R1.1
unnamed: DC1.4 (+VOUT), U1.1 (VCC)
unnamed: BT2.-, DC1.2 (+VIN)
unnamed: R1.2, U2.1 (P1.1/UCA0CLK/ACLK/C1/A1)
unnamed: R8.1, U4.2 (VOUT)
unnamed: R6.1, R7.2
unnamed: R5.1, R6.2
unnamed: R7.1, U2.16 (P1.2/UCA0RXD/UCA0SOMI/TB0TRG/C2/A2/VERE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), U3.1 (VOUTA)
unnamed: R5.2, R8.2, U3.3 (VINA+)
VCC: U3.8 (VDD)
