fabiomatos999/ICOM-4217-Project/PROTOTYPE INTEGRATION and System Updates/System-Schematic-Diagrams/Sub-Unit/SUB-UNIT.sch

## EAGLE design PROTOTYPE INTEGRATION and System Updates/System-Schematic-Diagrams/Sub-Unit/SUB-UNIT.sch (2023-04-27)

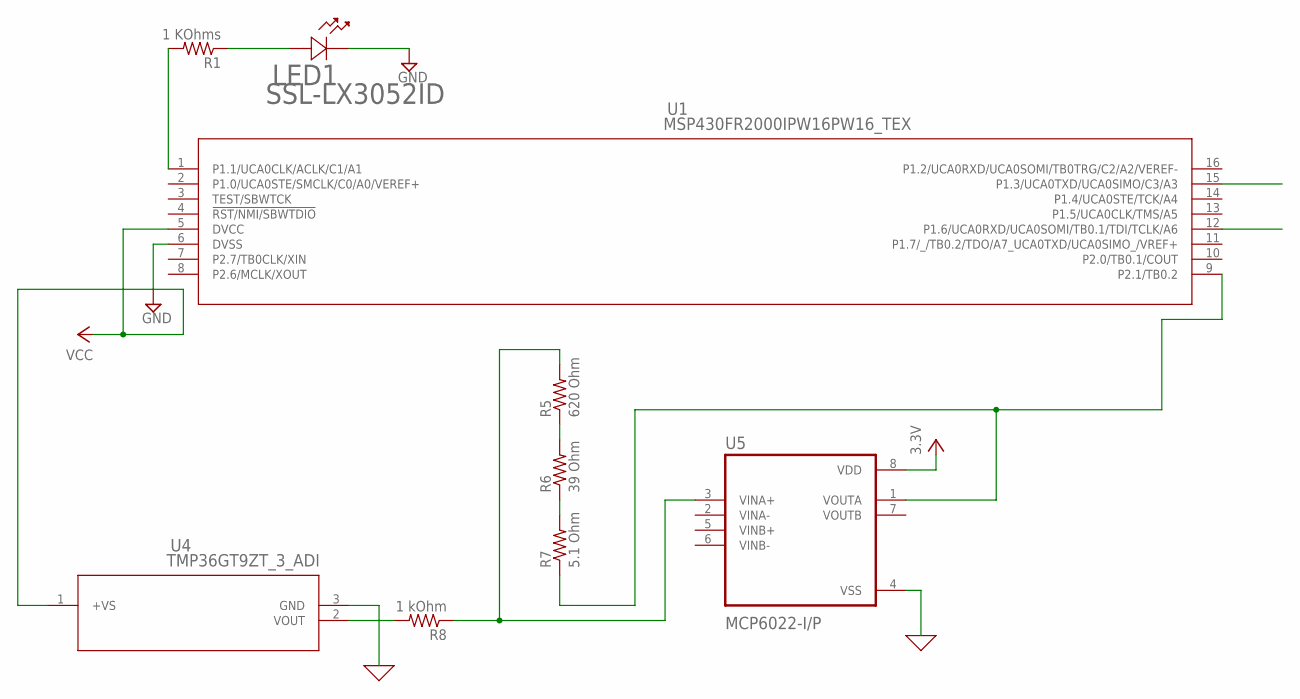
[picture p69: schematic SUB-UNIT.sch]

Parts:
LED1: SSL-LX3052ID; LED_SSL-LX30_T-3_LUM
R1: 1 KOhms; 0204/5
R5: 620 Ohm; 0204/7
R6: 39 Ohm; 0204/7
R7: 5.1 Ohm; 0204/7
R8: 1 kOhm; 0204/7
U1: MSP430FR2000IPW16PW16_TEX; PW16_TEX
U4: TMP36GT9ZT_3_ADI; T_3_ADI
U5: MCP6022-I/P; DIP787W46P254L927H533Q8

Connections:
0: U4.3 (GND), U5.4 (VSS)
GND: LED1.1 (ANODE), U1.6 (DVSS)
unnamed: LED1.2, R1.1
unnamed: R1.2, U1.1 (P1.1/UCA0CLK/ACLK/C1/A1)
unnamed: R7.1, U1.9 (P2.1/TB0.2), U5.1 (VOUTA)
unnamed: R8.2, U4.2 (VOUT)
unnamed: R6.1, R7.2
unnamed: R5.1, R6.2
unnamed: R5.2, R8.1, U5.3 (VINA+)
VCC: U1.5 (DVCC), U4.1 (+VS), U5.8 (VDD)
