fabiomatos999/ICOM-4217-Project/PROTOTYPE INTEGRATION and System Updates/System-Schematic-Diagrams/Power-Supply/Sub Unit PSU/sub-unit-psu.sch

## EAGLE design PROTOTYPE INTEGRATION and System Updates/System-Schematic-Diagrams/Power-Supply/Sub Unit PSU/sub-unit-psu.sch (2023-04-27)

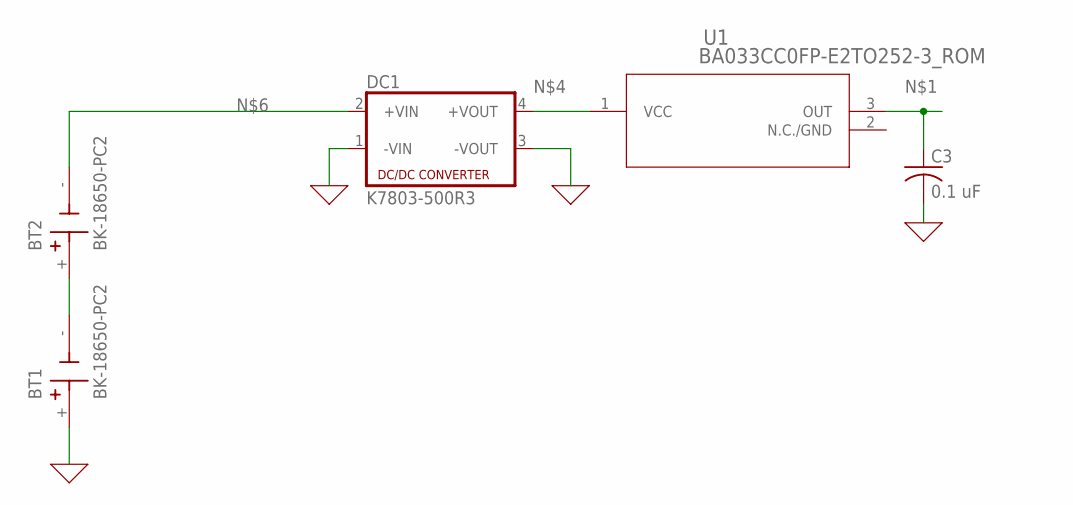
[picture p71: schematic sub-unit-psu.sch]

Parts:
BT1, BT2: BK-18650-PC2; BAT_BK-18650-PC2
C3: 0.1 uF; C050-024X044
DC1: K7803-500R3; NME
U1: BA033CC0FP-E2TO252-3_ROM; TO252-3_ROM

Connections:
0: BT1.+, C3.2, DC1.1 (-VIN), DC1.3 (-VOUT)
unnamed: C3.1, U1.3 (OUT)
unnamed: BT1.-, BT2.+
unnamed: DC1.4 (+VOUT), U1.1 (VCC)
unnamed: BT2.-, DC1.2 (+VIN)
