fabiomatos999/ICOM-4217-Project/(commit log)

2023-03-02 Started Flowcharts
2023-03-03 Finished sub unit flowchart
2023-03-04 Started main unit and sub unit psu
    [main-unit-psu.sch, sub-unit-psu.sch]
2023-03-05 Fixed errors in flowcharts
2023-03-05 Started BOM for main and sub unit psu
    [main-unit-psu.sch]
2023-03-05 Finished finding parts
    [main-unit-psu.sch]
2023-03-06 Fixed main psu and BOM
2023-03-07 Updated BOM and finished analysis for main/sub psu
2023-03-07 Added battery, need to fix analysis
2023-03-07 Fixed voltage analysis
2023-03-07 Fixed diode
2023-03-07 Uploaded main and unit sch
    [main-unit-psu.sch, sub-unit-psu.sch]
2023-03-08 Fixed main and sub unit psu sch
    [main-unit-psu.sch, sub-unit-psu.sch]
2023-03-08 Fixed 3.3 regulator and BOM
    [main-unit-psu.sch, sub-unit-psu.sch]
2023-03-09 Finished most of BOM and added list of tables
2023-03-09 Fixed error in sub-unit BOM
2023-03-09 Fixed main and sub unit designs for voltage compat
    [main-unit-psu.sch, sub-unit-psu.sch]
2023-03-09 Fixed label and added total to BOM
    [main-unit-psu.sch]
2023-03-09 Redid voltage analysis
2023-03-10 Finished BOM,analysis and diagrams for PSUs
    [main-unit-psu.sch, sub-unit-psu.sch]
2023-03-13 Added Main Unit
    Added Main Unit Schematics and updated BOM with new parts
    [Main-Unit-Schematic.sch]
2023-03-13 Updated BOM for Main Unit
2023-03-13 Sub Unit Schematics added
    [SUB-UNIT.sch]
2023-03-13 Integraded members parts
    [main-unit-psu.sch, sub-unit-and-psu.sch]
2023-03-13 Fixed R1 value
    [SUB-UNIT.sch]
2023-03-13 BOM R1 Updated
2023-03-13 Finished Sub Unit voltage analysis
2023-03-27 Fixed BOM after purchasing parts
2023-03-28 Fixed schematics
    [Main-Unit-Schematic.sch]
2023-03-28 Fixed typos in BOM
2023-03-28 Added 5v regulator to schematics
    [Main-Unit-Schematic.sch, SUB-UNIT.sch, main-unit-psu.sch, sub-unit-and-psu.sch]
2023-03-28 Fixed BOM, again.
2023-03-28 Finished BOM
2023-03-28 Added 5V regulator to PSU schematics
    [main-unit-psu.sch, sub-unit-psu.sch]
2023-04-06 Fixed system schematics
    [Main-Unit-Schematic.sch, SUB-UNIT.sch, main-unit-psu.sch, sub-unit-and-psu.sch]
2023-04-06 Finished BOM, SCH, 1/3 of Modules
    [Main-Unit-Schematic.sch, SUB-UNIT.sch, main-unit-psu.sch, sub-unit-and-psu.sch, sub-unit-psu.sch]
2023-04-07 Added main/sub flowcharts and pseudo code
2023-04-19 Fixed typo, added argument printers
    [bluetooth.h]
2023-04-25 Fixed ADC
2023-04-25 Added resolution to ADC
2023-04-25 Fixed bugs with temperature sensor
    [main.c, temperatureSensor.h]
2023-04-25 Fixed RTC Clock bug
    [main.c, temperatureSensor.h]
2023-04-26 Started report 5
    [Main-Unit-Schematic.sch, SUB-UNIT.sch, main-unit-psu.sch, sub-unit-and-psu.sch, sub-unit-psu.sch]
2023-04-27 Updated Main Unit
    Removed functions not in use and added voltage sensing code.
2023-04-27 Updated schematics and BOM
2023-04-27 Updated Individual schematics, bd and pictures
    [main-unit-psu.sch, sub-unit-psu.sch]
2023-04-28 Fixed printing bug
2023-05-03 Going through power analysis
2023-05-04 Fixing main unit flowcharts
2023-05-05 Added comprehensive schematics
