fabiomatos999/ICOM-4217-Project/(notices)

Notices in the files:
parts and their libraries:
2023-03-08_12-17-23_Library: COPYRIGHT: Copyright (C) 2023 Ultra Librarian. All rights reserved.
